AerospaceNU/karman-pcb/Karman Eagle/Karman Projects/Dev Board/Current/Rev 1/Pictures/IMG_20190504_142327.jpg

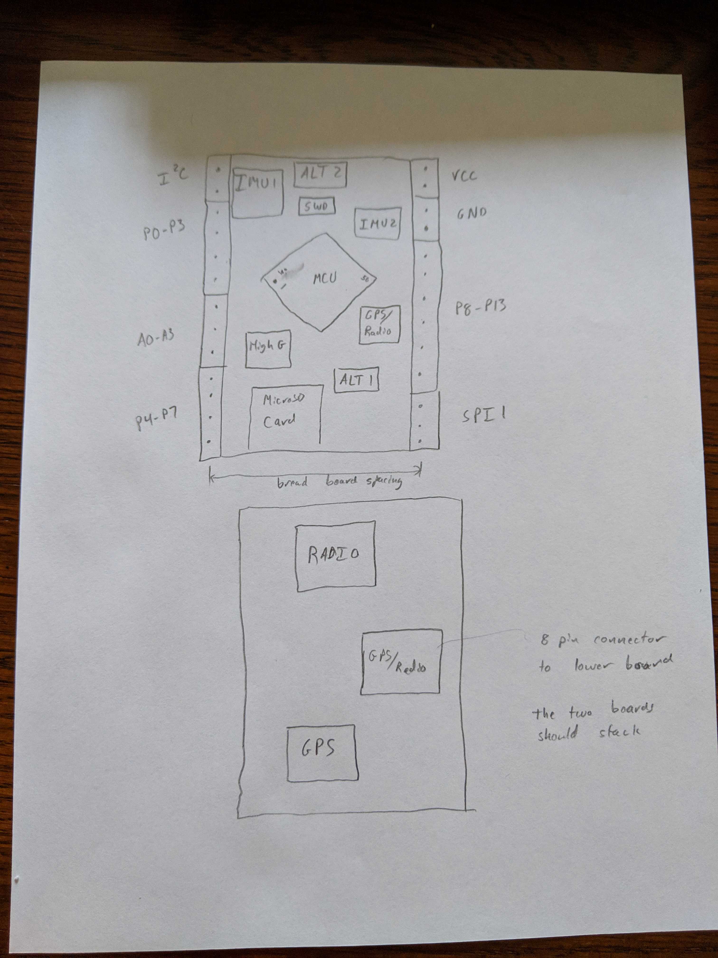
Karman Eagle/Karman Projects/Dev Board/Current/Rev 1/Pictures/IMG_20190504_142327.jpg
