AerospaceNU/karman-pcb/Karman Eagle/Karman Projects/Dev Board/Current/Rev 1/Pictures/20190513_203405.jpg

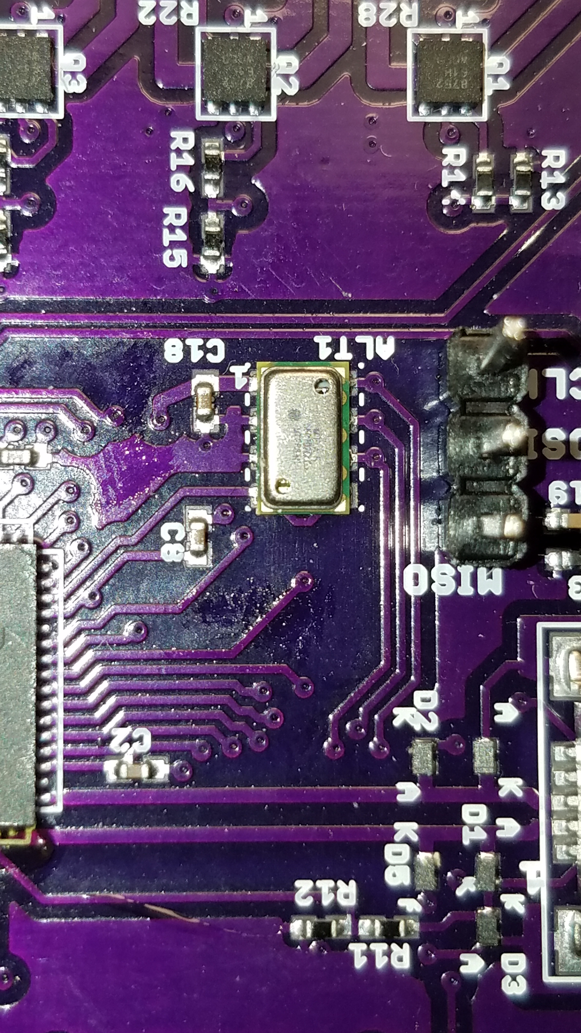
Karman Eagle/Karman Projects/Dev Board/Current/Rev 1/Pictures/20190513_203405.jpg
