AerospaceNU/karman-pcb/README.md

# karman-pcb
F.R.I.D.A.Y Board Pin Assignments:
https://docs.google.com/spreadsheets/d/11na9Qc9M955UdeKwvUbW7dzbBuk4ku73/edit#gid=1635462536
