AerospaceNU/karman-pcb/Karman Eagle/File Structure Explanation.docx

Karman Eagle File Structure

The file structure is based off this guy:

http://www.kieranoleary.com/eagle-pcb-project-directory-structure/

I did this to try and keep all our Eagle files as organized as possible since it’s difficult to move and change files around later.

Structure Tree:

Karman Eagle

Karman Libraries

Component Datasheets

<Library for each component>

Karman Projects

Dev Board

Archive

Current

Rev 1

Bill of Materials

Calculations

PDF

Pictures

Reviews

<Dev Board.sch>

<Dev Board.brd>

<eagle.epf>

GPS-Radio Module

Archive

Current

Rev 1

Bill of Materials

Calculations

PDF

Pictures

Reviews

<Dev Board.sch>

<Dev Board.brd>

<eagle.epf>
