AerospaceNU/karman-pcb/Karman Eagle/Karman Projects/Dev Board/Current/Rev 1/Calculations/Crystal Oscillator Capacitor Calculation.pdf

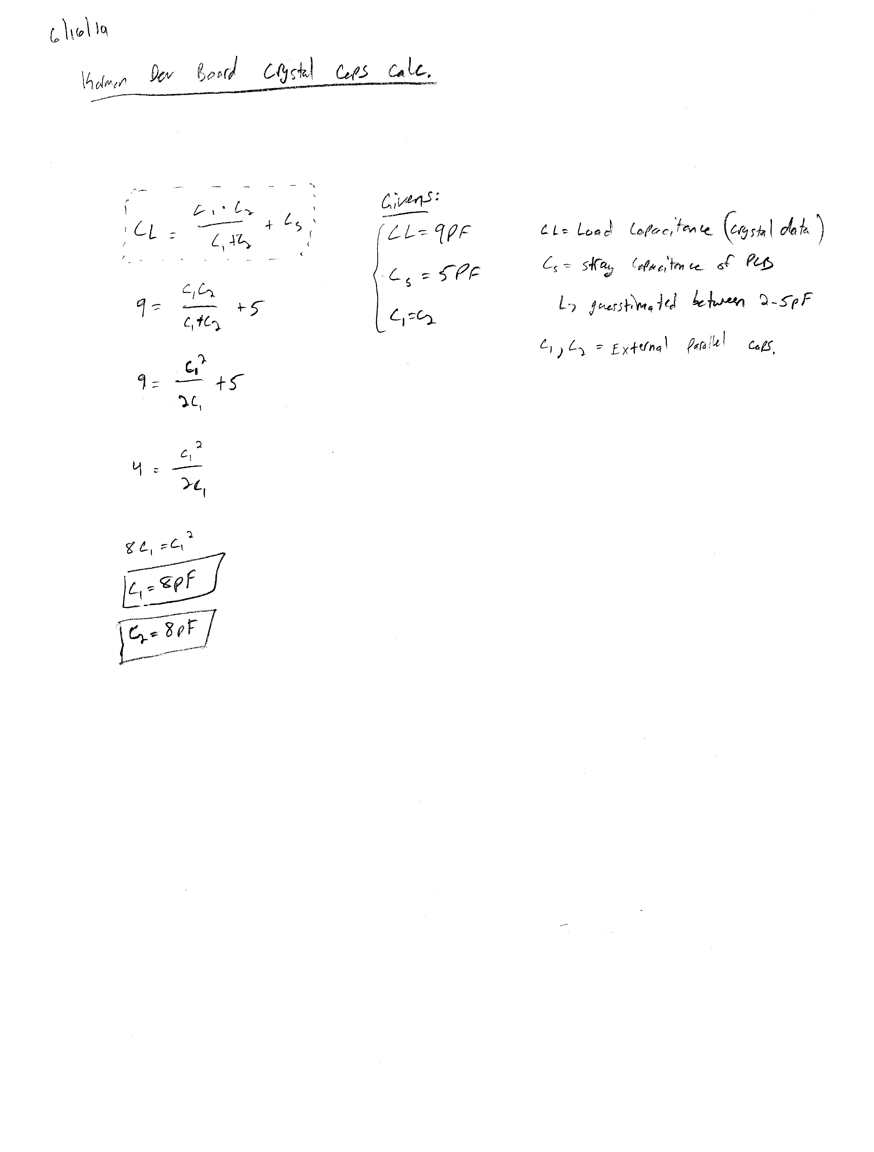
[picture p3: page 1]
