AerospaceNU/karman-pcb/Karman Eagle/Karman Projects/Dev Board/Current/Rev 1/Board Exports/190801-Dev Board Rev 1 Layout.png

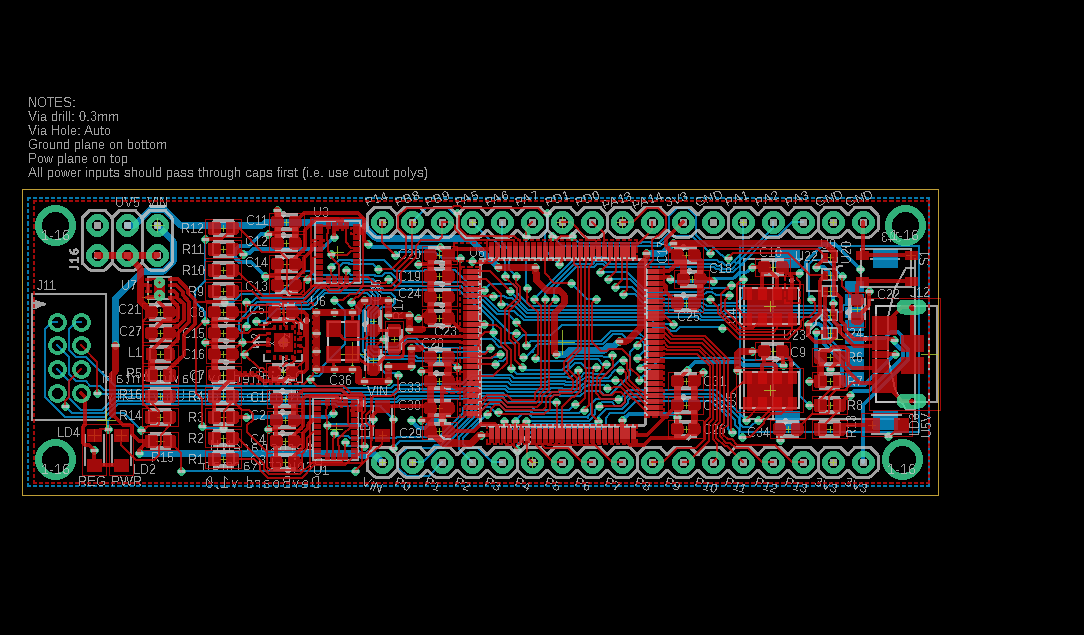
Karman Eagle/Karman Projects/Dev Board/Current/Rev 1/Board Exports/190801-Dev Board Rev 1 Layout.png
