AerospaceNU/karman-pcb/Karman Eagle/Karman Projects/Dev Board/Current/Rev 1/Board Exports/1906262044-Dev Board.png

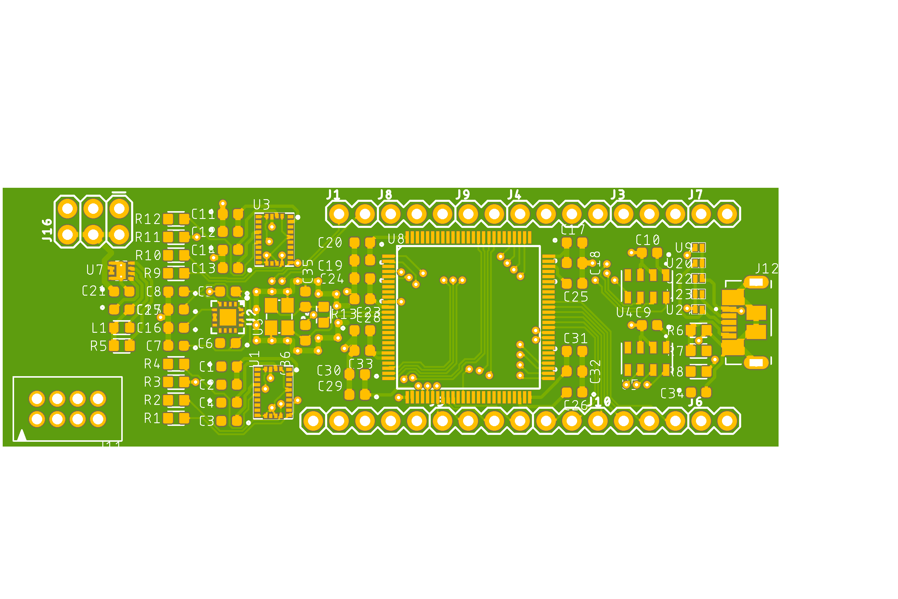
Karman Eagle/Karman Projects/Dev Board/Current/Rev 1/Board Exports/1906262044-Dev Board.png
