AerospaceNU/karman-pcb/Karman Eagle/Karman Projects/Dev Board/Current/Rev 1/Bill of Materials/1906152158-Dev Board BOM.xlsx

Column1 | Column2 | Column3 | Column4 | Column5 | Column8 | Column10 | Column11
Part | Value | Device | Package | Description | DESCRIPTION | MP | PACKAGE
C1 | 120nF | CGA3E2X7R1H104K080AD | CAPC1608X95N | CGA Series 0603 0.1 uF 50 V Â±10% X7R SMT Multilayer Ceramic Capacitor | CGA Series 0603 0.1 uF 50 V Â±10% X7R SMT Multilayer Ceramic Capacitor | CGA3E2X7R1H104K080AD | 0603 TDK
C2 | 6.8nF | CGA3E2X7R1H104K080AD | CAPC1608X95N | CGA Series 0603 0.1 uF 50 V Â±10% X7R SMT Multilayer Ceramic Capacitor | CGA Series 0603 0.1 uF 50 V Â±10% X7R SMT Multilayer Ceramic Capacitor | CGA3E2X7R1H104K080AD | 0603 TDK
C3 | 100nF | CGA3E2X7R1H104K080AD | CAPC1608X95N | CGA Series 0603 0.1 uF 50 V Â±10% X7R SMT Multilayer Ceramic Capacitor | CGA Series 0603 0.1 uF 50 V Â±10% X7R SMT Multilayer Ceramic Capacitor | CGA3E2X7R1H104K080AD | 0603 TDK
C4 | 100nF | CGA3E2X7R1H104K080AD | CAPC1608X95N | CGA Series 0603 0.1 uF 50 V Â±10% X7R SMT Multilayer Ceramic Capacitor | CGA Series 0603 0.1 uF 50 V Â±10% X7R SMT Multilayer Ceramic Capacitor | CGA3E2X7R1H104K080AD | 0603 TDK
C5 | 100nF | CGA3E2X7R1H104K080AD | CAPC1608X95N | CGA Series 0603 0.1 uF 50 V Â±10% X7R SMT Multilayer Ceramic Capacitor | CGA Series 0603 0.1 uF 50 V Â±10% X7R SMT Multilayer Ceramic Capacitor | CGA3E2X7R1H104K080AD | 0603 TDK
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
C25 | 2.2uF | CGA3E2X7R1H104K080AD | CAPC1608X95N | CGA Series 0603 0.1 uF 50 V Â±10% X7R SMT Multilayer Ceramic Capacitor | CGA Series 0603 0.1 uF 50 V Â±10% X7R SMT Multilayer Ceramic Capacitor | CGA3E2X7R1H104K080AD | 0603 TDK
C26 | 2.2uF | CGA3E2X7R1H104K080AD | CAPC1608X95N | CGA Series 0603 0.1 uF 50 V Â±10% X7R SMT Multilayer Ceramic Capacitor | CGA Series 0603 0.1 uF 50 V Â±10% X7R SMT Multilayer Ceramic Capacitor | CGA3E2X7R1H104K080AD | 0603 TDK
C27 | 22uF | CGA3E2X7R1H104K080AD | CAPC1608X95N | CGA Series 0603 0.1 uF 50 V Â±10% X7R SMT Multilayer Ceramic Capacitor | CGA Series 0603 0.1 uF 50 V Â±10% X7R SMT Multilayer Ceramic Capacitor | CGA3E2X7R1H104K080AD | 0603 TDK
C28 | 1uF | CGA3E2X7R1H104K080AD | CAPC1608X95N | CGA Series 0603 0.1 uF 50 V Â±10% X7R SMT Multilayer Ceramic Capacitor | CGA Series 0603 0.1 uF 50 V Â±10% X7R SMT Multilayer Ceramic Capacitor | CGA3E2X7R1H104K080AD | 0603 TDK
C29 | 100nF | CGA3E2X7R1H104K080AD | CAPC1608X95N | CGA Series 0603 0.1 uF 50 V Â±10% X7R SMT Multilayer Ceramic Capacitor | CGA Series 0603 0.1 uF 50 V Â±10% X7R SMT Multilayer Ceramic Capacitor | CGA3E2X7R1H104K080AD | 0603 TDK
C30 | 4.7uF | CGA3E2X7R1H104K080AD | CAPC1608X95N | CGA Series 0603 0.1 uF 50 V Â±10% X7R SMT Multilayer Ceramic Capacitor | CGA Series 0603 0.1 uF 50 V Â±10% X7R SMT Multilayer Ceramic Capacitor | CGA3E2X7R1H104K080AD | 0603 TDK
C31 | 100nF | CGA3E2X7R1H104K080AD | CAPC1608X95N | CGA Series 0603 0.1 uF 50 V Â±10% X7R SMT Multilayer Ceramic Capacitor | CGA Series 0603 0.1 uF 50 V Â±10% X7R SMT Multilayer Ceramic Capacitor | CGA3E2X7R1H104K080AD | 0603 TDK
C32 | 4.7uF | CGA3E2X7R1H104K080AD | CAPC1608X95N | CGA Series 0603 0.1 uF 50 V Â±10% X7R SMT Multilayer Ceramic Capacitor | CGA Series 0603 0.1 uF 50 V Â±10% X7R SMT Multilayer Ceramic Capacitor | CGA3E2X7R1H104K080AD | 0603 TDK
C33 | 10nF | CGA3E2X7R1H104K080AD | CAPC1608X95N | CGA Series 0603 0.1 uF 50 V Â±10% X7R SMT Multilayer Ceramic Capacitor | CGA Series 0603 0.1 uF 50 V Â±10% X7R SMT Multilayer Ceramic Capacitor | CGA3E2X7R1H104K080AD | 0603 TDK
C34 | 4.7nF | CGA3E2X7R1H104K080AD | CAPC1608X95N | CGA Series 0603 0.1 uF 50 V Â±10% X7R SMT Multilayer Ceramic Capacitor | CGA Series 0603 0.1 uF 50 V Â±10% X7R SMT Multilayer Ceramic Capacitor | CGA3E2X7R1H104K080AD | 0603 TDK
J1 | I2C1 | CONN_02 | 1X02 | Multi connection point. Often used as Generic Header-pin footprint for 0.1 inch spaced/style header connections
J2 | P0-P3 | CONN_04 | 1X04 | Multi connection point. Often used as Generic Header-pin footprint for 0.1 inch spaced/style header connections
J3 | A0-A3 | CONN_03 | 1X03 | Multi connection point. Often used as Generic Header-pin footprint for 0.1 inch spaced/style header connections
J4 | Debug | CONN_04 | 1X04 | Multi connection point. Often used as Generic Header-pin footprint for 0.1 inch spaced/style header connections
J5 | P4-P7 | CONN_04 | 1X04 | Multi connection point. Often used as Generic Header-pin footprint for 0.1 inch spaced/style header connections
J6 | VCC | CONN_02 | 1X02 | Multi connection point. Often used as Generic Header-pin footprint for 0.1 inch spaced/style header connections
J7 | GND | CONN_02 | 1X02 | Multi connection point. Often used as Generic Header-pin footprint for 0.1 inch spaced/style header connections
J8 | SPI1 | CONN_03 | 1X03 | Multi connection point. Often used as Generic Header-pin footprint for 0.1 inch spaced/style header connections
J9 | UART5 | CONN_02 | 1X02 | Multi connection point. Often used as Generic Header-pin footprint for 0.1 inch spaced/style header connections
J10 | P8-P13 | CONN_06LOCK | 1X06_LOCK | Multi connection point. Often used as Generic Header-pin footprint for 0.1 inch spaced/style header connections
J11 |  | 087831-0819 | 87831-0819
J12 | 105164-0001 | 105164-0001 | MOLEX_105164-0001 | Micro-USB B Receptacle without Flange, Top Mount, Surface Mount, Lead-Free | Micro-USB B Receptacle without Flange, Top Mount, Surface Mount, Lead-Free | 105164-0001 | None
J43 | 47219-2001 | 47219-2001 | MOLEX_47219-2001 | 1.10mm Pitch microSD Card Connector, Hinge Type, Lead-Freehttp://www.snapeda.com/parts/47219-2001/Molex%20/%20Waldom/view-part/# | Conn Micro SD Card SKT 8 POS 1.1mm Solder RA SMD 0.5A/Contact Embossed T/R | 47219-2001 | None
L1 | 2.2uH | MLF1608E100J | INDC1608X95N | Ind Shielded Multi-Layer 10uH 5% 2MHz 30Q-Factor Ferrite 10mA 0603 | Inductor RF Chip Shielded Multi-Layer 10uH 5% 2MHz 30Q-Factor Ferrite 10mA 1.7Ohm DCR 0603 T/R | MLF1608E100J | 0603 TDK
R1 | 40k | CRGH0603F221K | RESC1608X50N | Res Thick Film 0603 221K Ohm 1% 1/5W Â±100ppm/Â°C Molded SMD SMD T/R | Res Thick Film 0603 221K Ohm 1% 1/5W Â±100ppm/Â°C Molded SMD SMD T/R | CRGH0603F221K | 0603 TE Connectivity
R2 | 40k | CRGH0603F221K | RESC1608X50N | Res Thick Film 0603 221K Ohm 1% 1/5W Â±100ppm/Â°C Molded SMD SMD T/R | Res Thick Film 0603 221K Ohm 1% 1/5W Â±100ppm/Â°C Molded SMD SMD T/R | CRGH0603F221K | 0603 TE Connectivity
R3 | 10k | CRGH0603F221K | RESC1608X50N | Res Thick Film 0603 221K Ohm 1% 1/5W Â±100ppm/Â°C Molded SMD SMD T/R | Res Thick Film 0603 221K Ohm 1% 1/5W Â±100ppm/Â°C Molded SMD SMD T/R | CRGH0603F221K | 0603 TE Connectivity
R4 | 10k | CRGH0603F221K | RESC1608X50N | Res Thick Film 0603 221K Ohm 1% 1/5W Â±100ppm/Â°C Molded SMD SMD T/R | Res Thick Film 0603 221K Ohm 1% 1/5W Â±100ppm/Â°C Molded SMD SMD T/R | CRGH0603F221K | 0603 TE Connectivity
R5 | 100k | CRGH0603F221K | RESC1608X50N | Res Thick Film 0603 221K Ohm 1% 1/5W Â±100ppm/Â°C Molded SMD SMD T/R | Res Thick Film 0603 221K Ohm 1% 1/5W Â±100ppm/Â°C Molded SMD SMD T/R | CRGH0603F221K | 0603 TE Connectivity
R6 | 1M | CRGH0603F221K | RESC1608X50N | Res Thick Film 0603 221K Ohm 1% 1/5W Â±100ppm/Â°C Molded SMD SMD T/R | Res Thick Film 0603 221K Ohm 1% 1/5W Â±100ppm/Â°C Molded SMD SMD T/R | CRGH0603F221K | 0603 TE Connectivity
R7 | 59k | CRGH0603F221K | RESC1608X50N | Res Thick Film 0603 221K Ohm 1% 1/5W Â±100ppm/Â°C Molded SMD SMD T/R | Res Thick Film 0603 221K Ohm 1% 1/5W Â±100ppm/Â°C Molded SMD SMD T/R | CRGH0603F221K | 0603 TE Connectivity
R8 | 42.2k | CRGH0603F221K | RESC1608X50N | Res Thick Film 0603 221K Ohm 1% 1/5W Â±100ppm/Â°C Molded SMD SMD T/R | Res Thick Film 0603 221K Ohm 1% 1/5W Â±100ppm/Â°C Molded SMD SMD T/R | CRGH0603F221K | 0603 TE Connectivity
R9 | 40k | CRGH0603F221K | RESC1608X50N | Res Thick Film 0603 221K Ohm 1% 1/5W Â±100ppm/Â°C Molded SMD SMD T/R | Res Thick Film 0603 221K Ohm 1% 1/5W Â±100ppm/Â°C Molded SMD SMD T/R | CRGH0603F221K | 0603 TE Connectivity
R10 | 40k | CRGH0603F221K | RESC1608X50N | Res Thick Film 0603 221K Ohm 1% 1/5W Â±100ppm/Â°C Molded SMD SMD T/R | Res Thick Film 0603 221K Ohm 1% 1/5W Â±100ppm/Â°C Molded SMD SMD T/R | CRGH0603F221K | 0603 TE Connectivity
R11 | 10k | CRGH0603F221K | RESC1608X50N | Res Thick Film 0603 221K Ohm 1% 1/5W Â±100ppm/Â°C Molded SMD SMD T/R | Res Thick Film 0603 221K Ohm 1% 1/5W Â±100ppm/Â°C Molded SMD SMD T/R | CRGH0603F221K | 0603 TE Connectivity
R12 | 10k | CRGH0603F221K | RESC1608X50N | Res Thick Film 0603 221K Ohm 1% 1/5W Â±100ppm/Â°C Molded SMD SMD T/R | Res Thick Film 0603 221K Ohm 1% 1/5W Â±100ppm/Â°C Molded SMD SMD T/R | CRGH0603F221K | 0603 TE Connectivity
U1 | BNO055 | BNO055 | LGA28R50P4X10_380X520X100 | BNO055 9-axis Absolute Orientation Sensor ( SiP ) w/Sensors and Sensor Fusion | BNO055 9-axis Absolute Orientation Sensor _ SiP _ w/Sensors and Sensor Fusion | BNO055 | LGA-28 Bosch
U2 | ADXL377 | ADXL377 | LFCSP-16-3X3 | Analog Devices ADXL377 Low Power 3-Axis Â±200 g Accelerometer with Analog Output | ADI Small, Low Power, 3-Axis +/-3g3x3x1.45mm | ADXL377 | None
U3 | BNO055 | BNO055 | LGA28R50P4X10_380X520X100 | BNO055 9-axis Absolute Orientation Sensor ( SiP ) w/Sensors and Sensor Fusion | BNO055 9-axis Absolute Orientation Sensor _ SiP _ w/Sensors and Sensor Fusion | BNO055 | LGA-28 Bosch
U4 | MS5607-02BA03 | MS5607-02BA03 | TE_MS860702BA01-50
U5 | MS5607-02BA03 | MS5607-02BA03 | TE_MS860702BA01-50
U6 | TSX-3225 | TSX-3225 | TSX-3225
U7 | TPS62172 | TPS62172 | TPS62172
U8 | STM32F767VIT6 | STM32F767VIT6 | LQFP100_14X14
U20 | PESD3V3S1UL | PESD3V3S1UL | SOD882 | PESD3V3S1UL Zener Diode
U22 | PESD3V3S1UL | PESD3V3S1UL | SOD882 | PESD3V3S1UL Zener Diode
U23 | PESD3V3S1UL | PESD3V3S1UL | SOD882 | PESD3V3S1UL Zener Diode
U24 | PESD3V3S1UL | PESD3V3S1UL | SOD882 | PESD3V3S1UL Zener Diode
