AerospaceNU/karman-pcb/Karman Eagle/Karman Projects/Dev Board/Current/Rev 1/Board Exports/1906262044-Dev Board (Actual Size).pdf

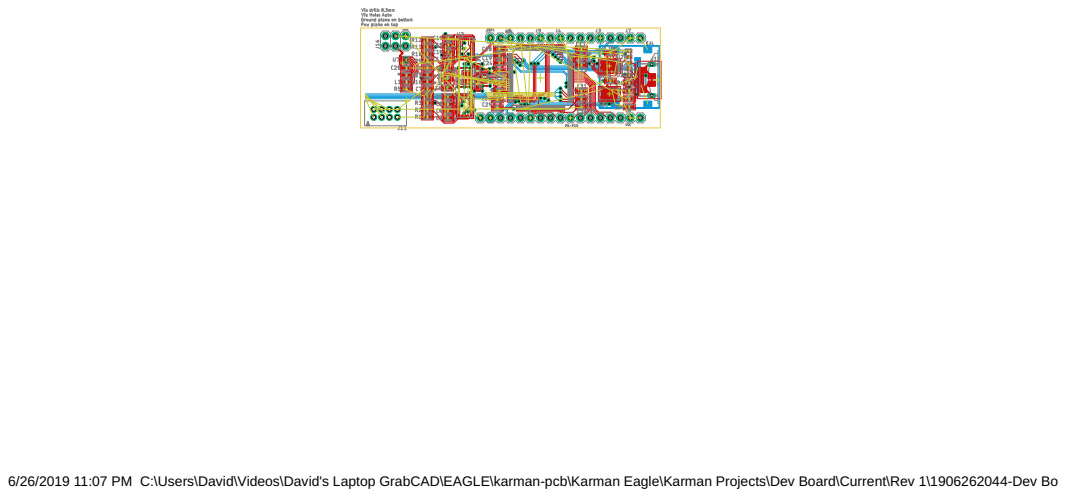
[picture p6: page 1]

6/26/2019 11:07 PM C:\Users\David\Videos\David's Laptop GrabCAD\EAGLE\karman-pcb\Karman Eagle\Karman Projects\Dev Board\Current\Rev 1\1906262044-Dev Board.brd
