AerospaceNU/karman-pcb/Karman Eagle/Karman Projects/Dev Board/Current/Rev 1/Board Exports/1906262044-Dev Board.pdf

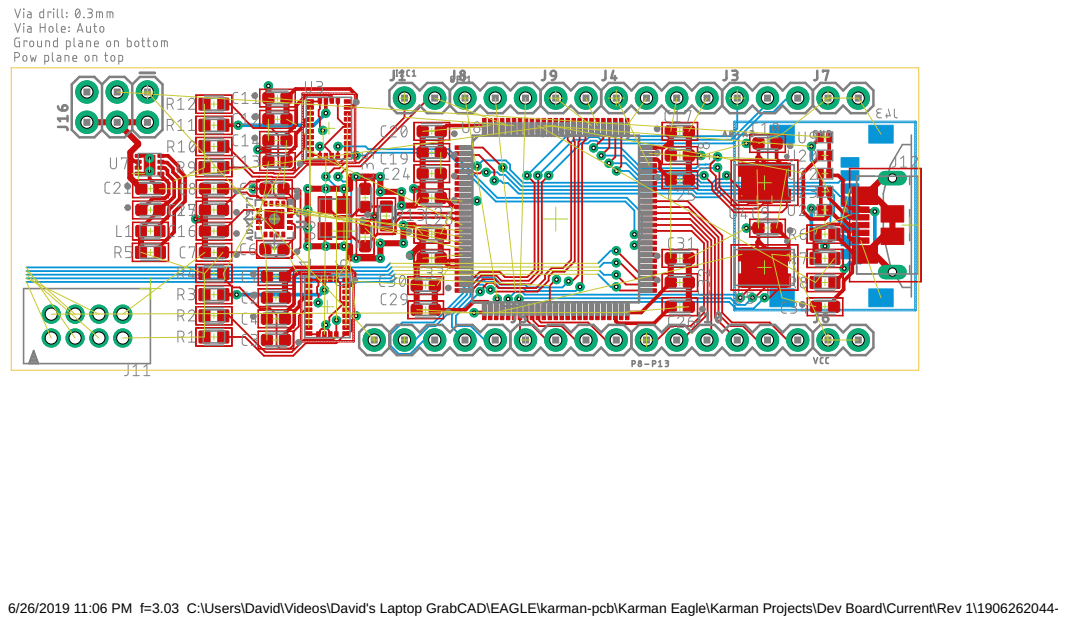
[picture p7: page 1]

6/26/2019 11:06 PM f=3.03 C:\Users\David\Videos\David's Laptop GrabCAD\EAGLE\karman-pcb\Karman Eagle\Karman Projects\Dev Board\Current\Rev 1\1906262044-Dev Board.brd
