AerospaceNU/karman-pcb/Karman Eagle/Karman Projects/Dev Board/Current/Rev 1/Reviews/1905251245-Dev Board [ISSUED FOR REVIEW].pdf

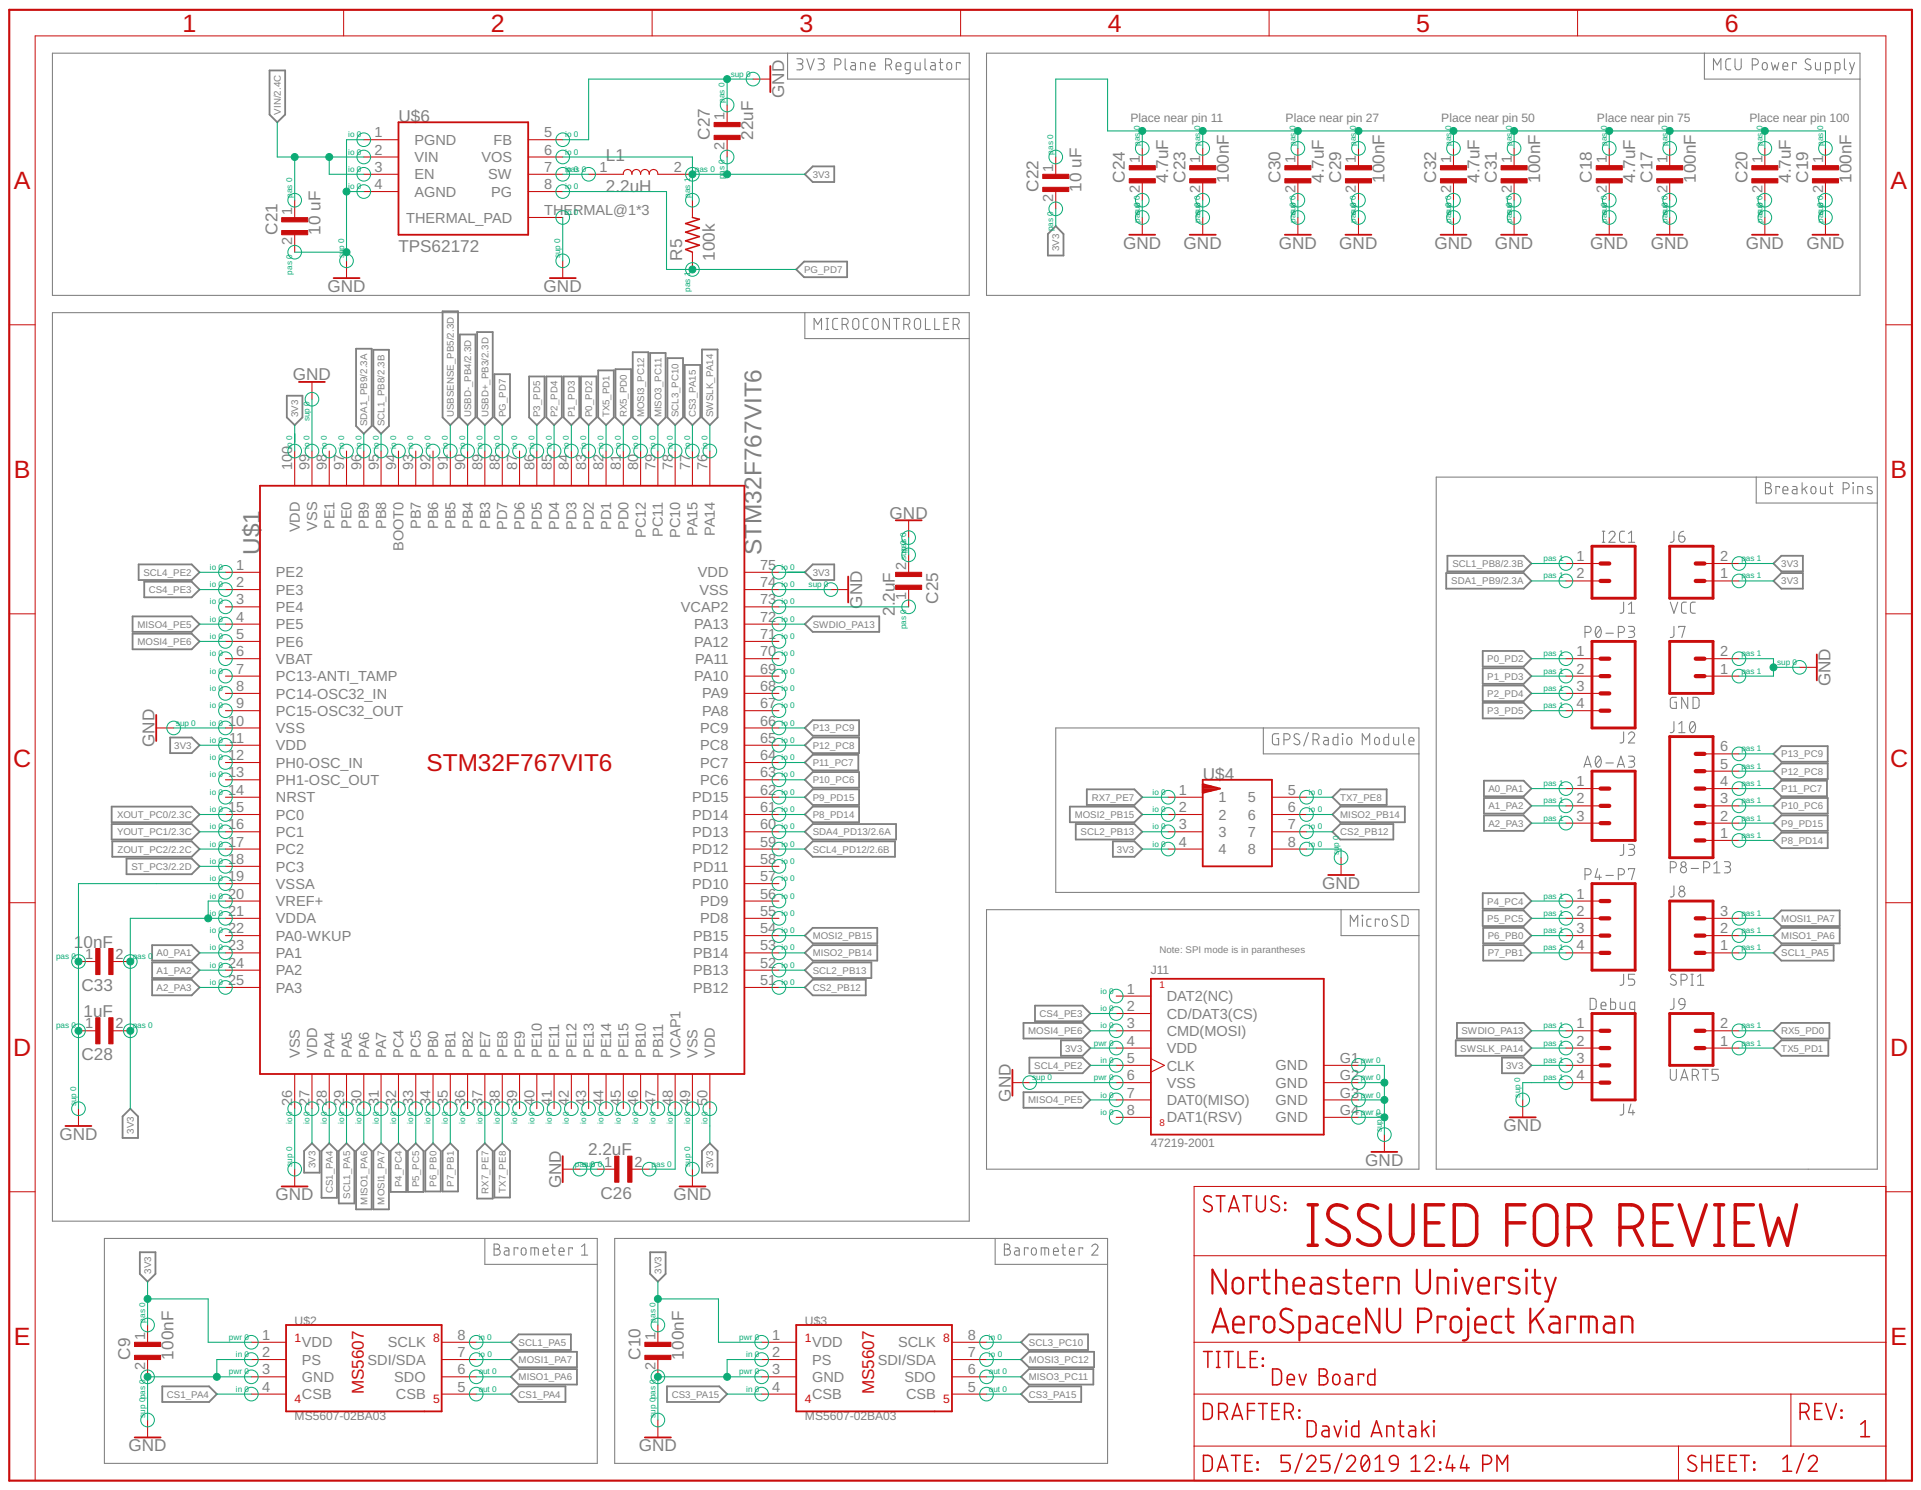
[picture p8: page 1]

Note: SPI mode is in parantheses

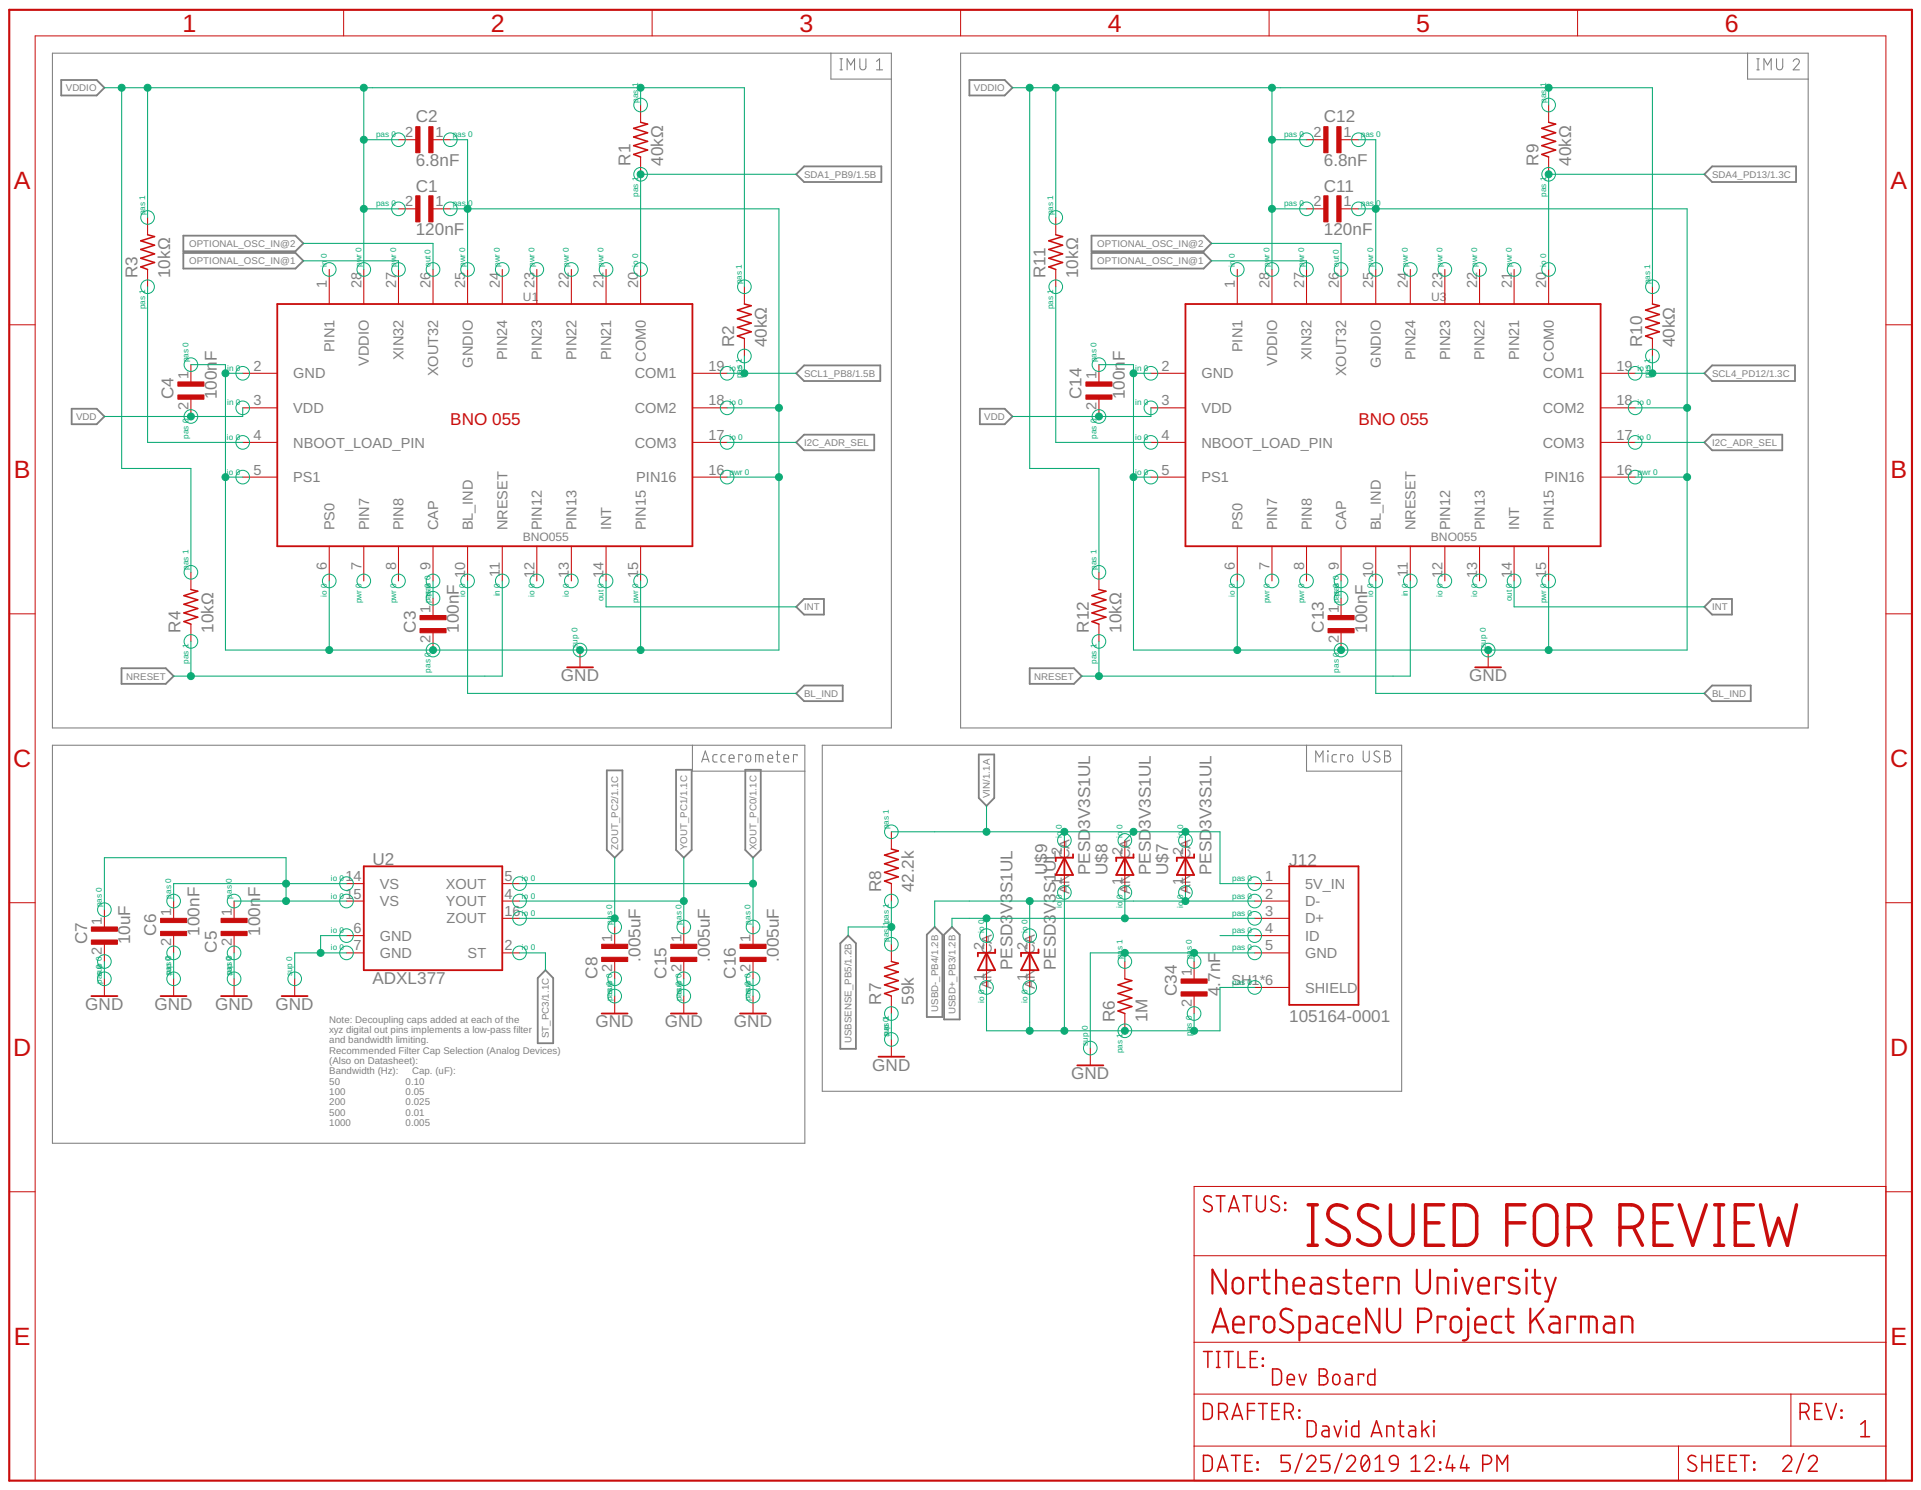
[picture p9: page 2]

pas 1 pas 1 pas 1 pas 1 sup 0

Note: Decoupling caps added at each of the
xyz digital out pins implements a low-pass filter and bandwidth limiting. Recommended Filter Cap Selection (Analog Devices)
