AerospaceNU/karman-pcb/Karman Eagle/Karman Projects/Dev Board/Current/Rev 1/1908011900-Dev Board.brd

## EAGLE design Karman Eagle/Karman Projects/Dev Board/Current/Rev 1/1908011900-Dev Board.brd (2020-05-07)

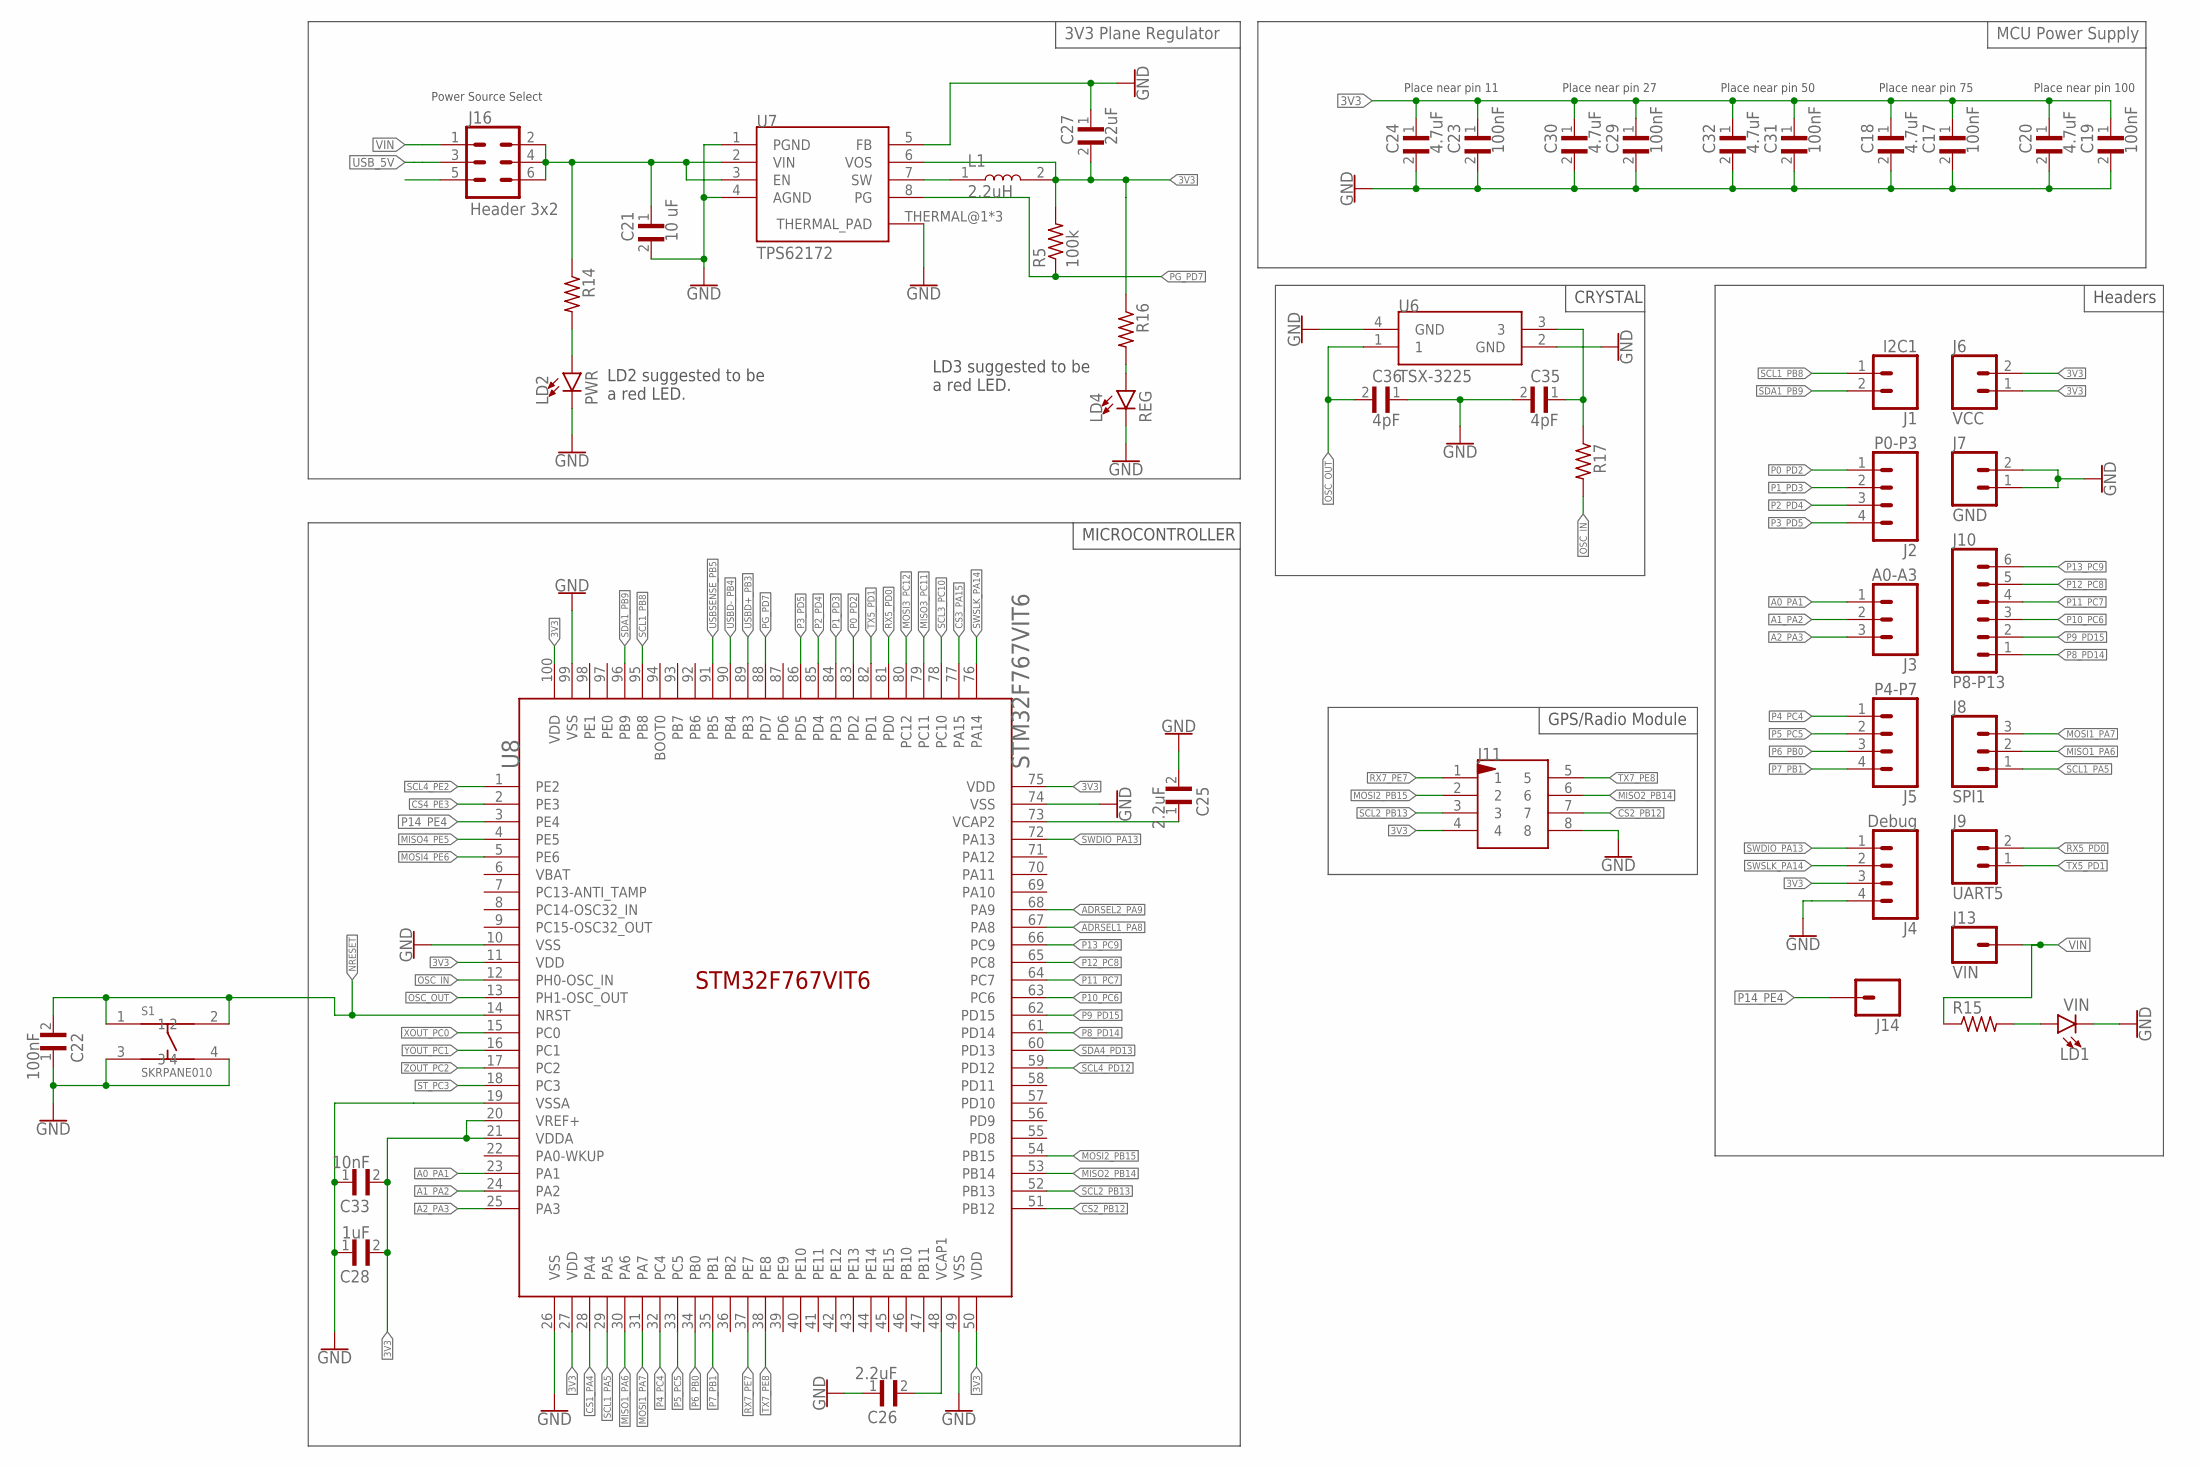
[picture p10: schematic 1908011900-Dev Board.sch, sheet 1]

Parts:
C17, C19, C22, C23, C29, C31: 100nF; CAPC1608X95N
C18, C20, C24, C30, C32: 4.7uF; CAPC1608X95N
C21: 10 uF; CAPC1608X95N
C25, C26: 2.2uF; CAPC1608X95N
C27: 22uF; CAPC1608X95N
C28: 1uF; CAPC1608X95N
C33: 10nF; CAPC1608X95N
C35, C36: 4pF; CAPC1608X95N
J1: I2C1; 1X02
J2: P0-P3; 1X04
J3: A0-A3; 1X03
J4: Debug; 1X04
J5: P4-P7; 1X04
J6: VCC; 1X02
J7: GND; 1X02
J8: SPI1; 1X03
J9: UART5; 1X02
J10: P8-P13; 1X06
J11: 087831-0819; 87831-0819
J13: VIN; 1X01
J14: CONN_01; 1X01
J16: Header 3x2; 2X3
L1: 2.2uH; INDC1608X95N
LD1: VIN; 0805_LED
LD2: PWR; 0805_LED
LD4: REG; 0805_LED
R5: 100k; RESC1608X50N
R14, R15, R16, R17: CRGH0603F221K; RESC1608X50N
S1: SKRPANE010
U6: TSX-3225
U7: TPS62172
U8: STM32F767VIT6; LQFP100_14X14

Connections:
3V3: C17.1, C18.1, C19.1, C20.1, C23.1, C24.1, C27.2, C28.2, C29.1, C30.1, C31.1, C32.1, C33.2, J4.3, J6.1, J6.2, J11.4, L1.2, R5.2, R16.1, U7.6 (VOS), U8.11 (VDD), U8.20 (VREF+), U8.21 (VDDA), U8.27 (VDD), U8.50 (VDD), U8.75 (VDD), U8.100 (VDD); also elsewhere on the board
A0_PA1: J3.1, U8.23 (PA1)
A1_PA2: J3.2, U8.24 (PA2)
A2_PA3: J3.3, U8.25 (PA3)
ADRSEL1_PA8: U8.67 (PA8); also elsewhere on the board
ADRSEL2_PA9: U8.68 (PA9); also elsewhere on the board
CS1_PA4: U8.28 (PA4); also elsewhere on the board
CS2_PB12: J11.7, U8.51 (PB12)
CS3_PA15: U8.77 (PA15); also elsewhere on the board
CS4_PE3: U8.2 (PE3); also elsewhere on the board
GND: C17.2, C18.2, C19.2, C20.2, C21.2, C22.1, C23.2, C24.2, C25.2, C26.1, C28.1, C29.2, C30.2, C31.2, C32.2, C33.1, C35.2, C36.1, J4.4, J7.1, J7.2, J11.8, LD1.C, LD2.C, LD4.C, S1.3, S1.4, U6.2 (GND), U6.4 (GND), U7.1 (PGND), U7.4 (AGND), U7.THERMAL@1 (THERMAL_PAD), U7.THERMAL@2 (THERMAL_PAD), U7.THERMAL@3 (THERMAL_PAD), U8.10 (VSS), U8.19 (VSSA), U8.26 (VSS), U8.49 (VSS), U8.74 (VSS), U8.99 (VSS); also elsewhere on the board
MISO1_PA6: J8.2, U8.30 (PA6); also elsewhere on the board
MISO2_PB14: J11.6, U8.53 (PB14)
MISO3_PC11: U8.79 (PC11); also elsewhere on the board
MISO4_PE5: U8.4 (PE5); also elsewhere on the board
MOSI1_PA7: J8.3, U8.31 (PA7); also elsewhere on the board
MOSI2_PB15: J11.2, U8.54 (PB15)
MOSI3_PC12: U8.80 (PC12); also elsewhere on the board
MOSI4_PE6: U8.5 (PE6); also elsewhere on the board
unnamed: C25.1, U8.73 (VCAP2)
unnamed: C26.2, U8.48 (VCAP1)
unnamed: L1.1, U7.7 (SW)
unnamed: LD1.A, R15.2
unnamed: LD2.A, R14.2
unnamed: C27.1, U7.5 (FB)
unnamed: C35.1, R17.1, U6.3
unnamed: C21.1, J16.2, J16.4, J16.6, R14.1, U7.2 (VIN), U7.3 (EN)
unnamed: LD4.A, R16.2
NRESET: C22.2, S1.1, S1.2, U8.14 (NRST); also elsewhere on the board
OSC_IN: R17.2, U8.12 (PH0-OSC_IN)
OSC_OUT: C36.2, U6.1, U8.13 (PH1-OSC_OUT)
P0_PD2: J2.1, U8.83 (PD2)
P1_PD3: J2.2, U8.84 (PD3)
P2_PD4: J2.3, U8.85 (PD4)
P3_PD5: J2.4, U8.86 (PD5)
P4_PC4: J5.1, U8.32 (PC4)
P5_PC5: J5.2, U8.33 (PC5)
P6_PB0: J5.3, U8.34 (PB0)
P7_PB1: J5.4, U8.35 (PB1)
P8_PD14: J10.1, U8.61 (PD14)
P9_PD15: J10.2, U8.62 (PD15)
P10_PC6: J10.3, U8.63 (PC6)
P11_PC7: J10.4, U8.64 (PC7)
P12_PC8: J10.5, U8.65 (PC8)
P13_PC9: J10.6, U8.66 (PC9)
P14_PE4: J14.1, U8.3 (PE4)
PG_PD7: R5.1, U7.8 (PG), U8.88 (PD7)
RX5_PD0: J9.2, U8.81 (PD0)
RX7_PE7: J11.1, U8.37 (PE7)
SCL1_PA5: J8.1, U8.29 (PA5); also elsewhere on the board
SCL1_PB8: J1.1, U8.95 (PB8); also elsewhere on the board
SCL2_PB13: J11.3, U8.52 (PB13)
SCL3_PC10: U8.78 (PC10); also elsewhere on the board
SCL4_PD12: U8.59 (PD12); also elsewhere on the board
SCL4_PE2: U8.1 (PE2); also elsewhere on the board
SDA1_PB9: J1.2, U8.96 (PB9); also elsewhere on the board
SDA4_PD13: U8.60 (PD13); also elsewhere on the board
ST_PC3: U8.18 (PC3); also elsewhere on the board
SWDIO_PA13: J4.1, U8.72 (PA13)
SWSLK_PA14: J4.2, U8.76 (PA14)
TX5_PD1: J9.1, U8.82 (PD1)
TX7_PE8: J11.5, U8.38 (PE8)
USBD+_PB3: U8.89 (PB3); also elsewhere on the board
USBD-_PB4: U8.90 (PB4); also elsewhere on the board
USBSENSE_PB5: U8.91 (PB5); also elsewhere on the board
USB_5V: J16.3; also elsewhere on the board
VIN: J13.1, J16.1, R15.1
XOUT_PC0: U8.15 (PC0); also elsewhere on the board
YOUT_PC1: U8.16 (PC1); also elsewhere on the board
ZOUT_PC2: U8.17 (PC2); also elsewhere on the board

Notes on the sheet:
MICROCONTROLLER
Headers
Place near pin 11
Place near pin 27
Place near pin 50
Place near pin 75
Place near pin 100
GPS/Radio Module
MCU Power Supply
3V3 Plane Regulator
CRYSTAL
Power Source Select
LD2 suggested to be a red LED.
LD3 suggested to be a red LED.

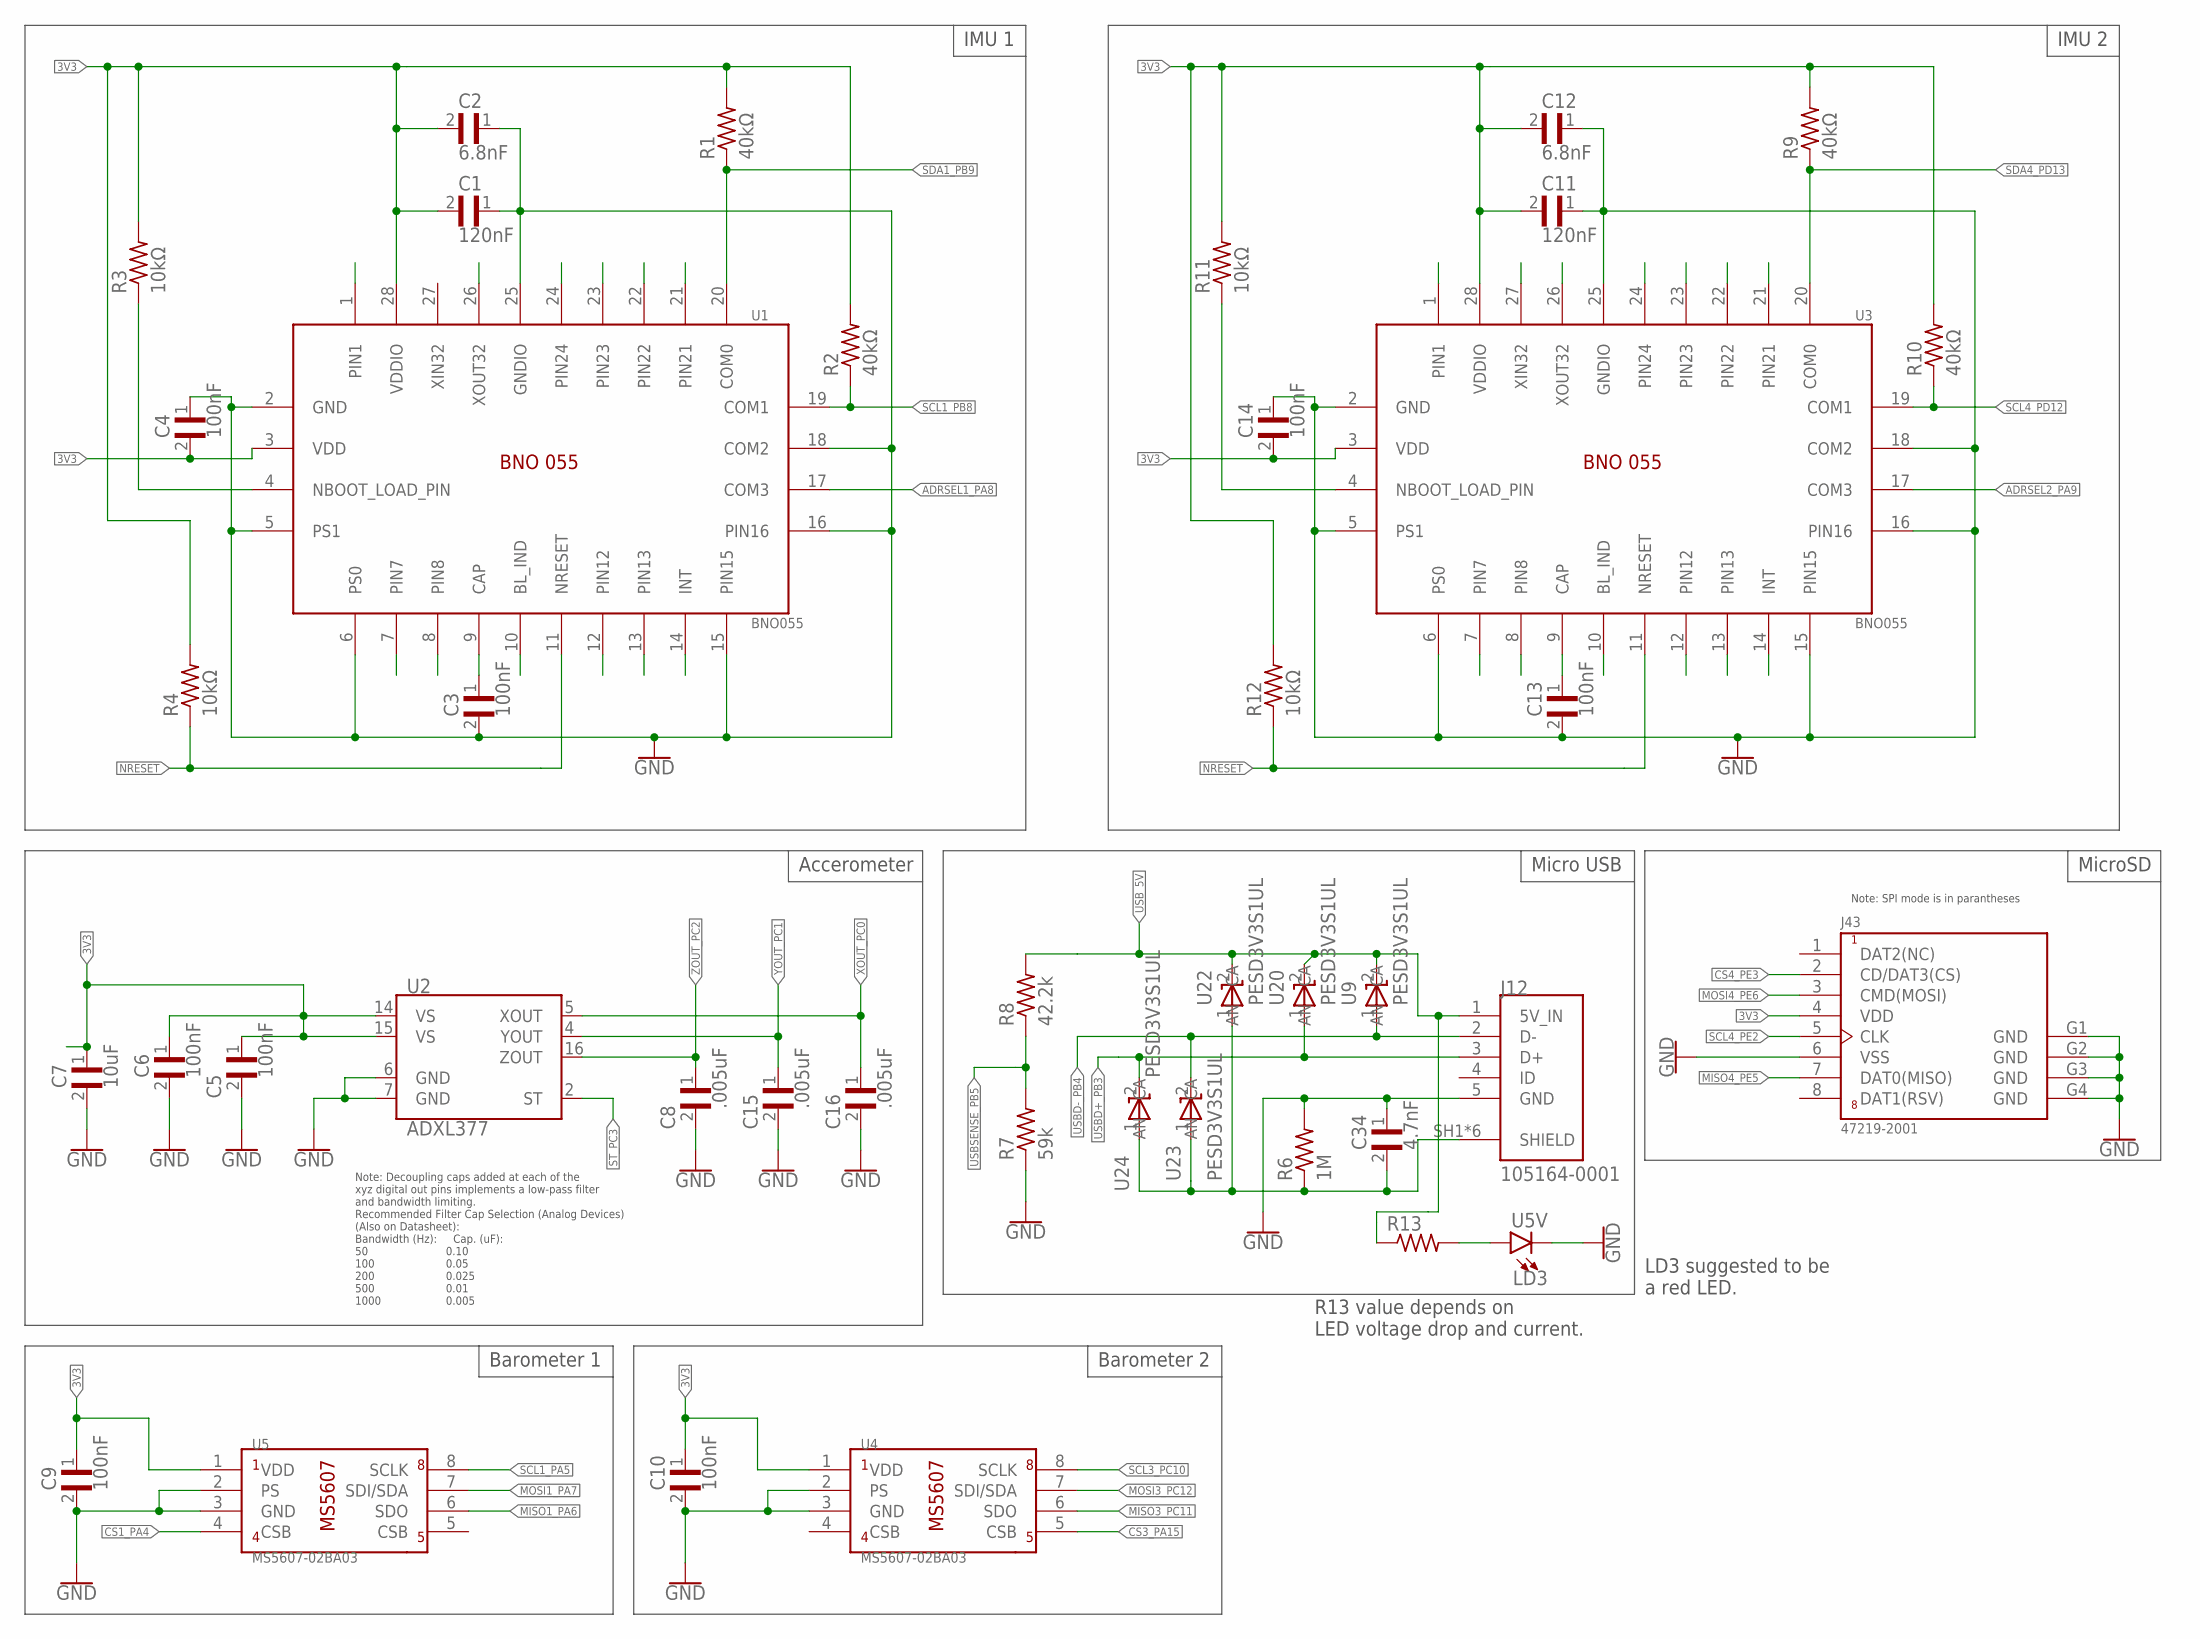
[picture p11: schematic 1908011900-Dev Board.sch, sheet 2]

Parts:
C1, C11: 120nF; CAPC1608X95N
C2, C12: 6.8nF; CAPC1608X95N
C3, C4, C5, C6, C9, C10, C13, C14: 100nF; CAPC1608X95N
C7: 10uF; CAPC1608X95N
C8, C15, C16: .005uF; CAPC1608X95N
C34: 4.7nF; CAPC1608X95N
J12: 105164-0001; MOLEX_105164-0001
J43: 47219-2001; MOLEX_47219-2001
LD3: U5V; 0805_LED
R1, R2, R9, R10: 40kΩ; RESC1608X50N
R3, R4, R11, R12: 10kΩ; RESC1608X50N
R6: 1M; RESC1608X50N
R7: 59k; RESC1608X50N
R8: 42.2k; RESC1608X50N
R13: CRGH0603F221K; RESC1608X50N
U1, U3: BNO055; LGA28R50P4X10_380X520X100
U2: ADXL377; LFCSP-16-3X3
U4, U5: MS5607-02BA03; TE_MS860702BA01-50
U9, U20, U22, U23, U24: PESD3V3S1UL; SOD882

Connections:
3V3: C1.2, C2.2, C4.2, C5.1, C6.1, C7.1, C9.1, C10.1, C11.2, C12.2, C14.2, J43.4 (VDD), R1.2, R2.2, R3.2, R4.2, R9.2, R10.2, R11.2, R12.2, U1.3 (VDD), U1.28 (VDDIO), U2.14 (VS), U2.15 (VS), U3.3 (VDD), U3.28 (VDDIO), U4.1 (VDD), U5.1 (VDD); also elsewhere on the board
ADRSEL1_PA8: U1.17 (COM3); also elsewhere on the board
ADRSEL2_PA9: U3.17 (COM3); also elsewhere on the board
CS1_PA4: U5.4 (CSB); also elsewhere on the board
CS3_PA15: U4.5 (CSB); also elsewhere on the board
CS4_PE3: J43.2 (CD/DAT3(CS)); also elsewhere on the board
GND: C1.1, C2.1, C3.2, C4.1, C5.2, C6.2, C7.2, C8.2, C9.2, C10.2, C11.1, C12.1, C13.2, C14.1, C15.2, C16.2, C34.1, J12.5 (GND), J43.6 (VSS), J43.G1 (GND), J43.G2 (GND), J43.G3 (GND), J43.G4 (GND), LD3.C, R6.2, R7.1, U1.2 (GND), U1.5 (PS1), U1.6 (PS0), U1.15 (PIN15), U1.16 (PIN16), U1.18 (COM2), U1.25 (GNDIO), U2.6 (GND), U2.7 (GND), U3.2 (GND), U3.5 (PS1), U3.6 (PS0), U3.15 (PIN15), U3.16 (PIN16), U3.18 (COM2), U3.25 (GNDIO), U4.2 (PS), U4.3 (GND), U5.2 (PS), U5.3 (GND); also elsewhere on the board
MISO1_PA6: U5.6 (SDO); also elsewhere on the board
MISO3_PC11: U4.6 (SDO); also elsewhere on the board
MISO4_PE5: J43.7 (DAT0(MISO)); also elsewhere on the board
MOSI1_PA7: U5.7 (SDI/SDA); also elsewhere on the board
MOSI3_PC12: U4.7 (SDI/SDA); also elsewhere on the board
MOSI4_PE6: J43.3 (CMD(MOSI)); also elsewhere on the board
unnamed: C3.1, U1.9 (CAP)
unnamed: R3.1, U1.4 (NBOOT_LOAD_PIN)
unnamed: C13.1, U3.9 (CAP)
unnamed: R11.1, U3.4 (NBOOT_LOAD_PIN)
unnamed: C34.2, J12.SH1 (SHIELD), J12.SH2 (SHIELD), J12.SH3 (SHIELD), J12.SH4 (SHIELD), J12.SH5 (SHIELD), J12.SH6 (SHIELD), R6.1, U22.1 (CA), U23.1 (CA), U24.1 (CA)
unnamed: LD3.A, R13.2
NRESET: R4.1, R12.1, U1.11 (NRESET), U3.11 (NRESET); also elsewhere on the board
SCL1_PA5: U5.8 (SCLK); also elsewhere on the board
SCL1_PB8: R2.1, U1.19 (COM1); also elsewhere on the board
SCL3_PC10: U4.8 (SCLK); also elsewhere on the board
SCL4_PD12: R10.1, U3.19 (COM1); also elsewhere on the board
SCL4_PE2: J43.5 (CLK); also elsewhere on the board
SDA1_PB9: R1.1, U1.20 (COM0); also elsewhere on the board
SDA4_PD13: R9.1, U3.20 (COM0); also elsewhere on the board
ST_PC3: U2.2 (ST); also elsewhere on the board
USBD+_PB3: J12.3 (D+), U20.1 (CA), U24.2 (AN); also elsewhere on the board
USBD-_PB4: J12.2 (D-), U9.1 (CA), U23.2 (AN); also elsewhere on the board
USBSENSE_PB5: R7.2, R8.1; also elsewhere on the board
USB_5V: J12.1 (5V_IN), R8.2, R13.1, U9.2 (AN), U20.2 (AN), U22.2 (AN); also elsewhere on the board
XIN32: U1.27 (XIN32)
XOUT_PC0: C16.1, U2.5 (XOUT); also elsewhere on the board
YOUT_PC1: C15.1, U2.4 (YOUT); also elsewhere on the board
ZOUT_PC2: C8.1, U2.16 (ZOUT); also elsewhere on the board

Notes on the sheet:
IMU 1
IMU 2
Note: Decoupling caps added at each of the xyz digital out pins implements a low-pass filter and bandwidth limiting. Recommended Filter Cap Selection (Analog Devices) (Also on Datasheet): Bandwidth (Hz): Cap. (uF): 50 0.10 100 0.05 200 0.025 500 0.01 1000 0.005
Accerometer
Micro USB
Barometer 1
Barometer 2
MicroSD
R13 value depends on LED voltage drop and current.
LD3 suggested to be a red LED.

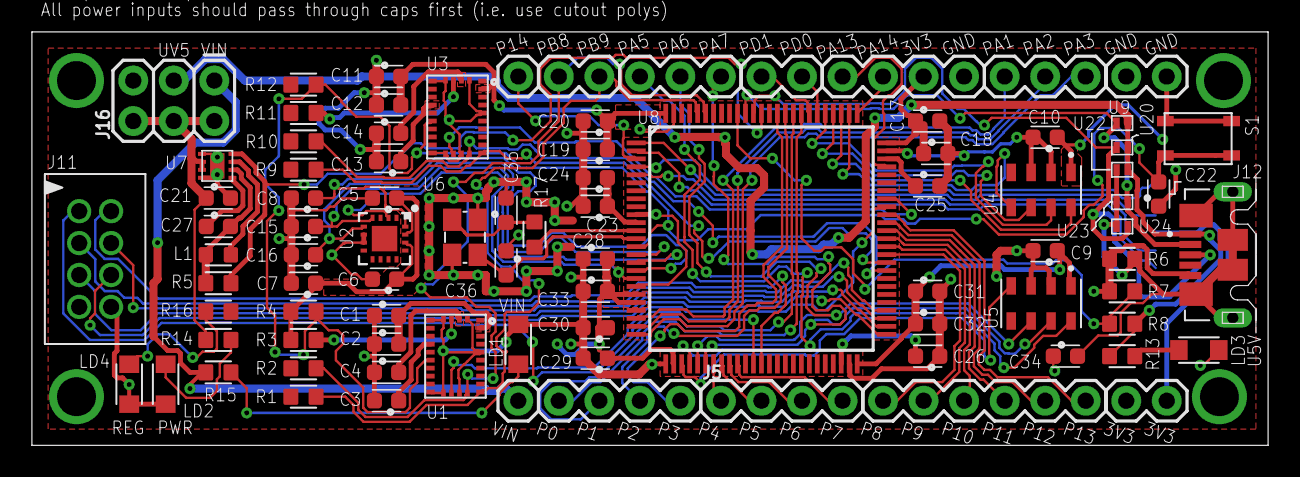
[picture p12: board 1908011900-Dev Board.brd from above]

Board: 2 copper layers, 77.5 x 25.9 mm, 88 parts (1 on the bottom side), 76 nets.
