AerospaceNU/karman-pcb/Karman Eagle/Karman Projects/Dev Board/Current/Rev 1/1906152157-Dev Board.brd

## EAGLE design Karman Eagle/Karman Projects/Dev Board/Current/Rev 1/1906152157-Dev Board.brd (2019-06-16)

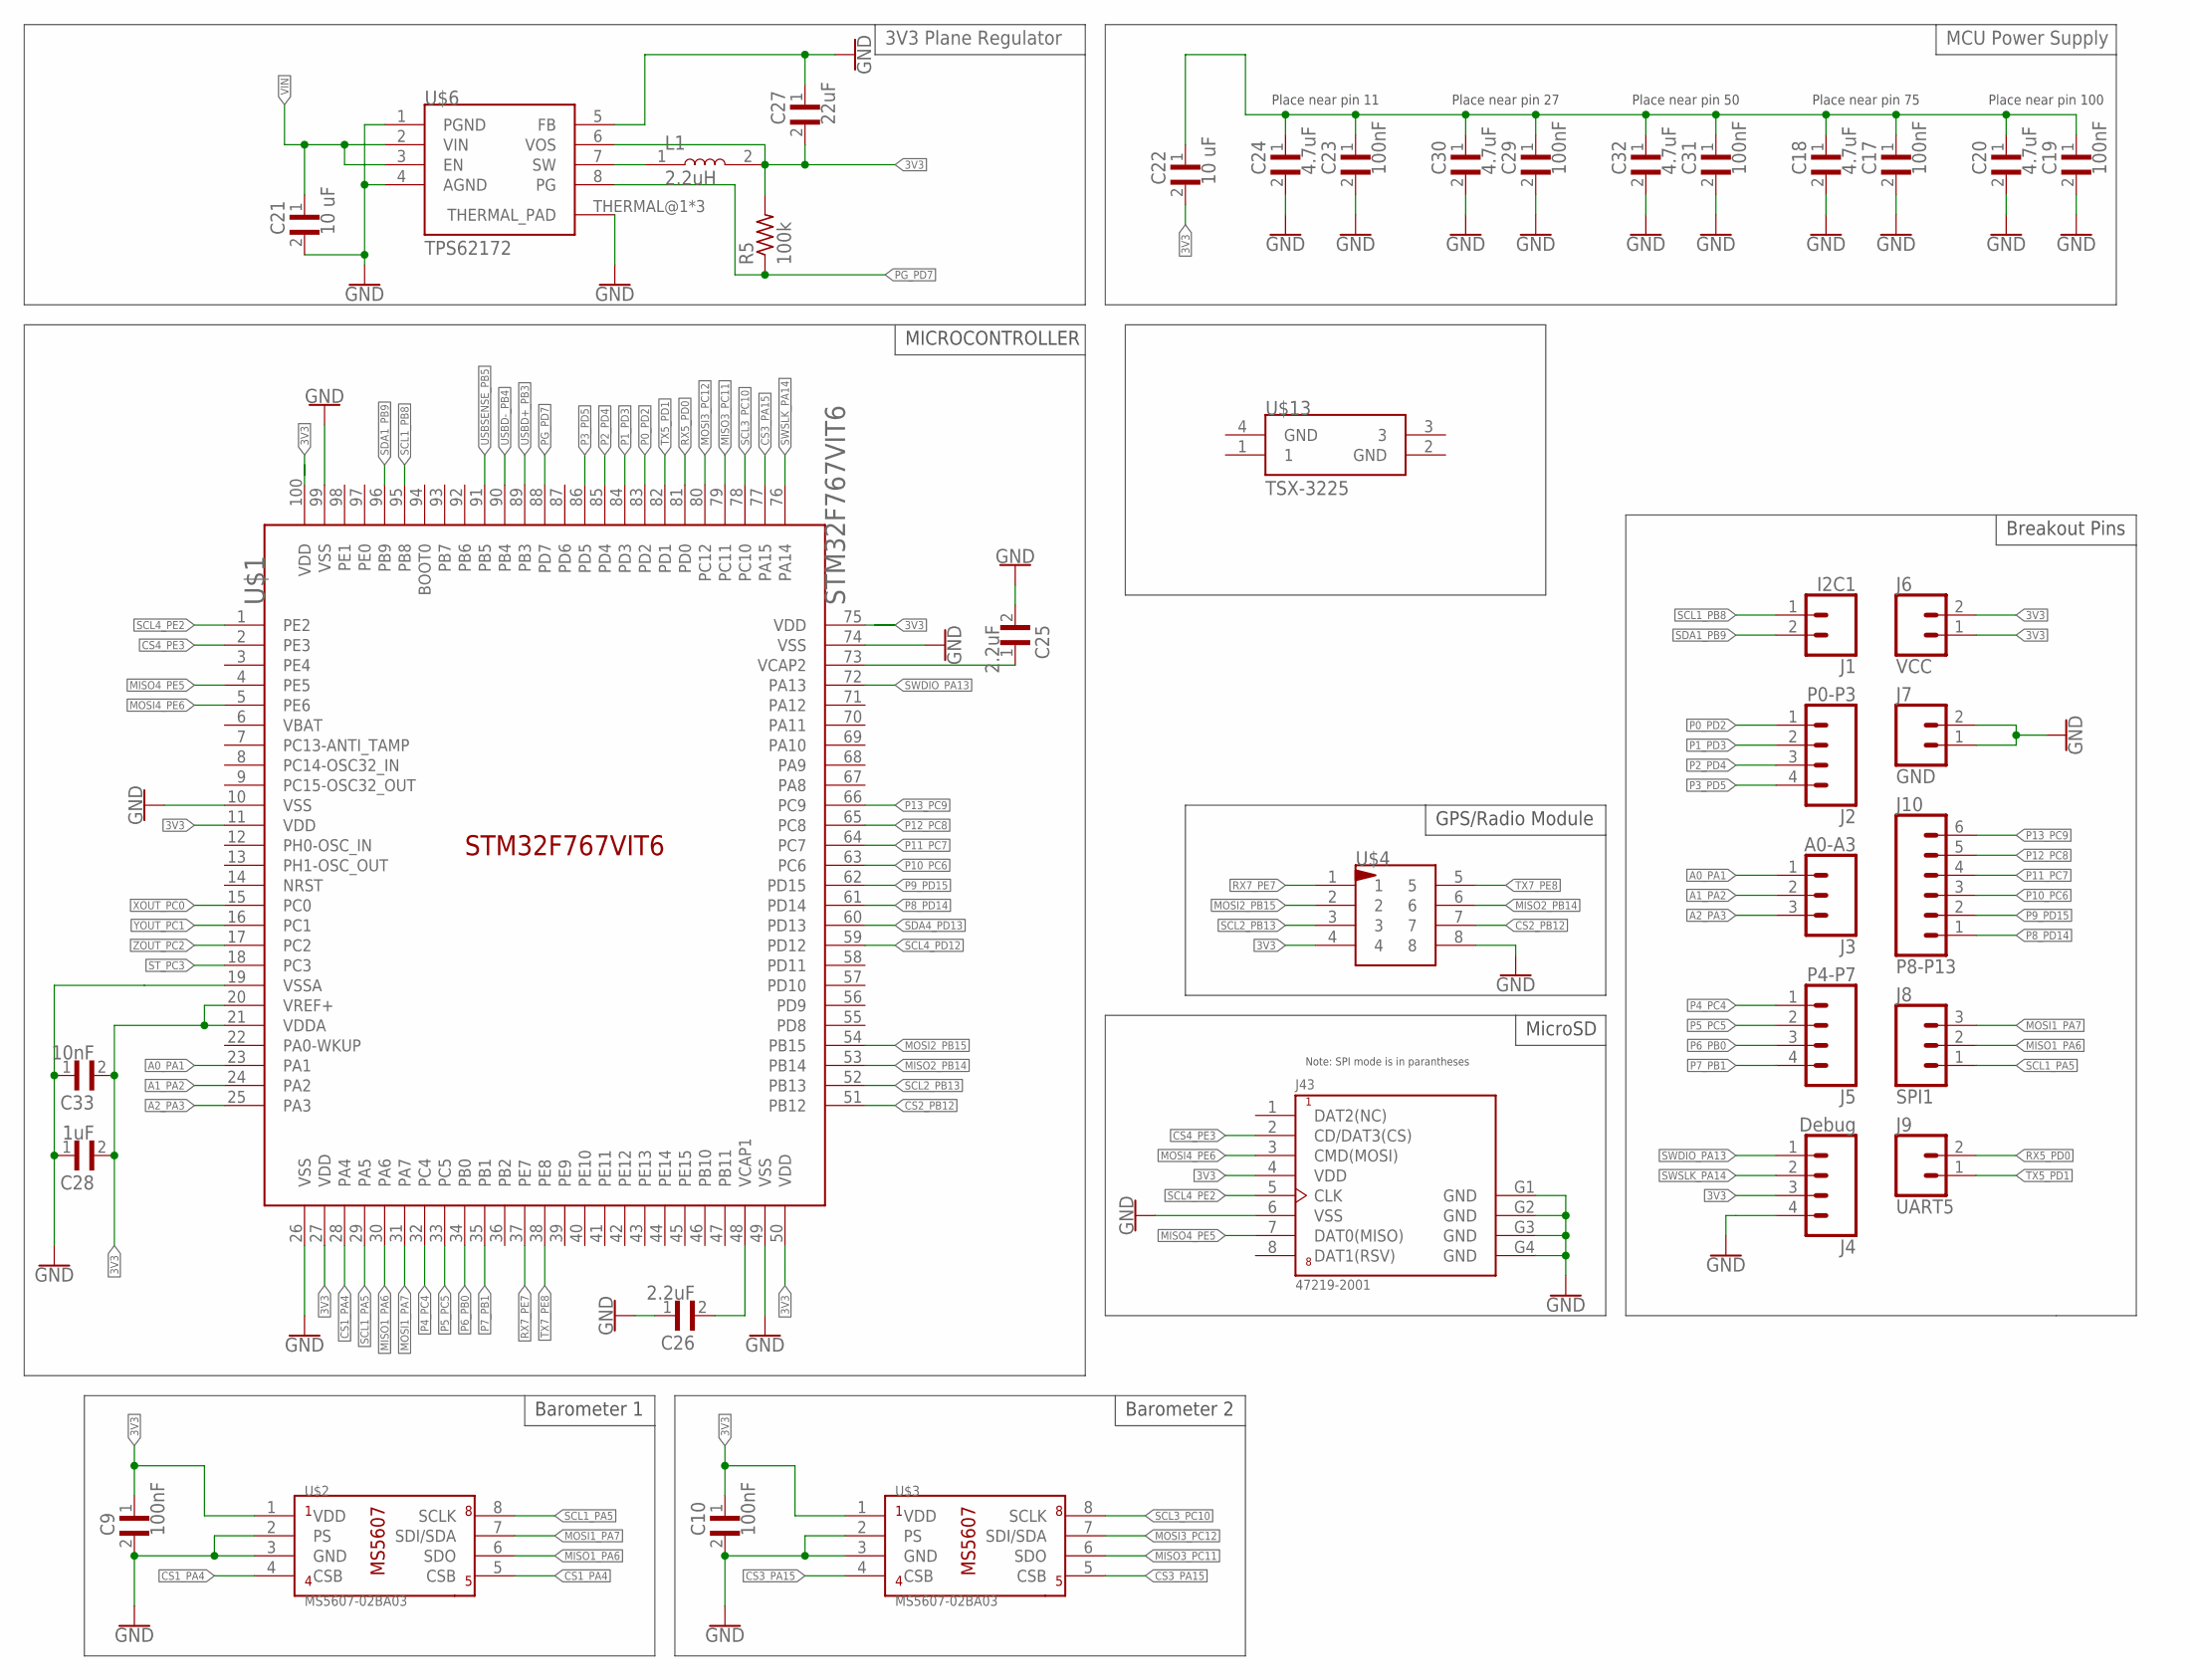
[picture p13: schematic 1906152157-Dev Board.sch, sheet 1]

Parts:
C9, C10, C17, C19, C23, C29, C31: 100nF; CAPC1608X95N
C18, C20, C24, C30, C32: 4.7uF; CAPC1608X95N
C21, C22: 10 uF; CAPC1608X95N
C25, C26: 2.2uF; CAPC1608X95N
C27: 22uF; CAPC1608X95N
C28: 1uF; CAPC1608X95N
C33: 10nF; CAPC1608X95N
J1: I2C1; 1X02
J2: P0-P3; 1X04
J3: A0-A3; 1X03
J4: Debug; 1X04
J5: P4-P7; 1X04
J6: VCC; 1X02
J7: GND; 1X02
J8: SPI1; 1X03
J9: UART5; 1X02
J10: P8-P13; 1X06_LOCK
J43: 47219-2001; MOLEX_47219-2001
L1: 2.2uH; INDC1608X95N
R5: 100k; RESC1608X50N
U$1: STM32F767VIT6; LQFP100_14X14
U$2, U$3: MS5607-02BA03; TE_MS860702BA01-50
U$4: 087831-0819; 87831-0819
U$6: TPS62172
U$13: TSX-3225

Connections:
3V3: C9.1, C10.1, C22.2, C27.2, C28.2, C33.2, J4.3, J6.1, J6.2, J43.4 (VDD), L1.2, R5.2, U$1.11 (VDD), U$1.20 (VREF+), U$1.21 (VDDA), U$1.27 (VDD), U$1.50 (VDD), U$1.75 (VDD), U$1.100 (VDD), U$2.1 (VDD), U$3.1 (VDD), U$4.4, U$6.6 (VOS)
A0_PA1: J3.1, U$1.23 (PA1)
A1_PA2: J3.2, U$1.24 (PA2)
A2_PA3: J3.3, U$1.25 (PA3)
CS1_PA4: U$1.28 (PA4), U$2.4 (CSB), U$2.5 (CSB)
CS2_PB12: U$1.51 (PB12), U$4.7
CS3_PA15: U$1.77 (PA15), U$3.4 (CSB), U$3.5 (CSB)
CS4_PE3: J43.2 (CD/DAT3(CS)), U$1.2 (PE3)
GND: C9.2, C10.2, C17.2, C18.2, C19.2, C20.2, C21.2, C23.2, C24.2, C25.2, C26.1, C27.1, C28.1, C29.2, C30.2, C31.2, C32.2, C33.1, J4.4, J7.1, J7.2, J43.6 (VSS), J43.G1 (GND), J43.G2 (GND), J43.G3 (GND), J43.G4 (GND), U$1.10 (VSS), U$1.19 (VSSA), U$1.26 (VSS), U$1.49 (VSS), U$1.74 (VSS), U$1.99 (VSS), U$2.2 (PS), U$2.3 (GND), U$3.2 (PS), U$3.3 (GND), U$4.8, U$6.1 (PGND), U$6.4 (AGND), U$6.5 (FB), U$6.THERMAL@1 (THERMAL_PAD), U$6.THERMAL@2 (THERMAL_PAD), U$6.THERMAL@3 (THERMAL_PAD); also elsewhere on the board
MISO1_PA6: J8.2, U$1.30 (PA6), U$2.6 (SDO)
MISO2_PB14: U$1.53 (PB14), U$4.6
MISO3_PC11: U$1.79 (PC11), U$3.6 (SDO)
MISO4_PE5: J43.7 (DAT0(MISO)), U$1.4 (PE5)
MOSI1_PA7: J8.3, U$1.31 (PA7), U$2.7 (SDI/SDA)
MOSI2_PB15: U$1.54 (PB15), U$4.2
MOSI3_PC12: U$1.80 (PC12), U$3.7 (SDI/SDA)
MOSI4_PE6: J43.3 (CMD(MOSI)), U$1.5 (PE6)
unnamed: C25.1, U$1.73 (VCAP2)
unnamed: C26.2, U$1.48 (VCAP1)
unnamed: L1.1, U$6.7 (SW)
unnamed: C17.1, C18.1, C19.1, C20.1, C22.1, C23.1, C24.1, C29.1, C30.1, C31.1, C32.1
P0_PD2: J2.1, U$1.83 (PD2)
P1_PD3: J2.2, U$1.84 (PD3)
P2_PD4: J2.3, U$1.85 (PD4)
P3_PD5: J2.4, U$1.86 (PD5)
P4_PC4: J5.1, U$1.32 (PC4)
P5_PC5: J5.2, U$1.33 (PC5)
P6_PB0: J5.3, U$1.34 (PB0)
P7_PB1: J5.4, U$1.35 (PB1)
P8_PD14: J10.1, U$1.61 (PD14)
P9_PD15: J10.2, U$1.62 (PD15)
P10_PC6: J10.3, U$1.63 (PC6)
P11_PC7: J10.4, U$1.64 (PC7)
P12_PC8: J10.5, U$1.65 (PC8)
P13_PC9: J10.6, U$1.66 (PC9)
PG_PD7: R5.1, U$1.88 (PD7), U$6.8 (PG)
RX5_PD0: J9.2, U$1.81 (PD0)
RX7_PE7: U$1.37 (PE7), U$4.1
SCL1_PA5: J8.1, U$1.29 (PA5), U$2.8 (SCLK)
SCL1_PB8: J1.1, U$1.95 (PB8); also elsewhere on the board
SCL2_PB13: U$1.52 (PB13), U$4.3
SCL3_PC10: U$1.78 (PC10), U$3.8 (SCLK)
SCL4_PD12: U$1.59 (PD12); also elsewhere on the board
SCL4_PE2: J43.5 (CLK), U$1.1 (PE2)
SDA1_PB9: J1.2, U$1.96 (PB9); also elsewhere on the board
SDA4_PD13: U$1.60 (PD13); also elsewhere on the board
ST_PC3: U$1.18 (PC3); also elsewhere on the board
SWDIO_PA13: J4.1, U$1.72 (PA13)
SWSLK_PA14: J4.2, U$1.76 (PA14)
TX5_PD1: J9.1, U$1.82 (PD1)
TX7_PE8: U$1.38 (PE8), U$4.5
USBD+_PB3: U$1.89 (PB3); also elsewhere on the board
USBD-_PB4: U$1.90 (PB4); also elsewhere on the board
USBSENSE_PB5: U$1.91 (PB5); also elsewhere on the board
VIN: C21.1, U$6.2 (VIN), U$6.3 (EN); also elsewhere on the board
XOUT_PC0: U$1.15 (PC0); also elsewhere on the board
YOUT_PC1: U$1.16 (PC1); also elsewhere on the board
ZOUT_PC2: U$1.17 (PC2); also elsewhere on the board

Notes on the sheet:
MICROCONTROLLER
Barometer 1
Barometer 2
Breakout Pins
Place near pin 11
Place near pin 27
Place near pin 50
Place near pin 75
Place near pin 100
GPS/Radio Module
MicroSD
MCU Power Supply
3V3 Plane Regulator
