AerospaceNU/karman-pcb/Karman Eagle/Karman Projects/Dev Board/Current/Rev 1/1906152157-Dev Board.brd

## EAGLE design Karman Eagle/Karman Projects/Dev Board/Current/Rev 1/1906152157-Dev Board.brd (continued)

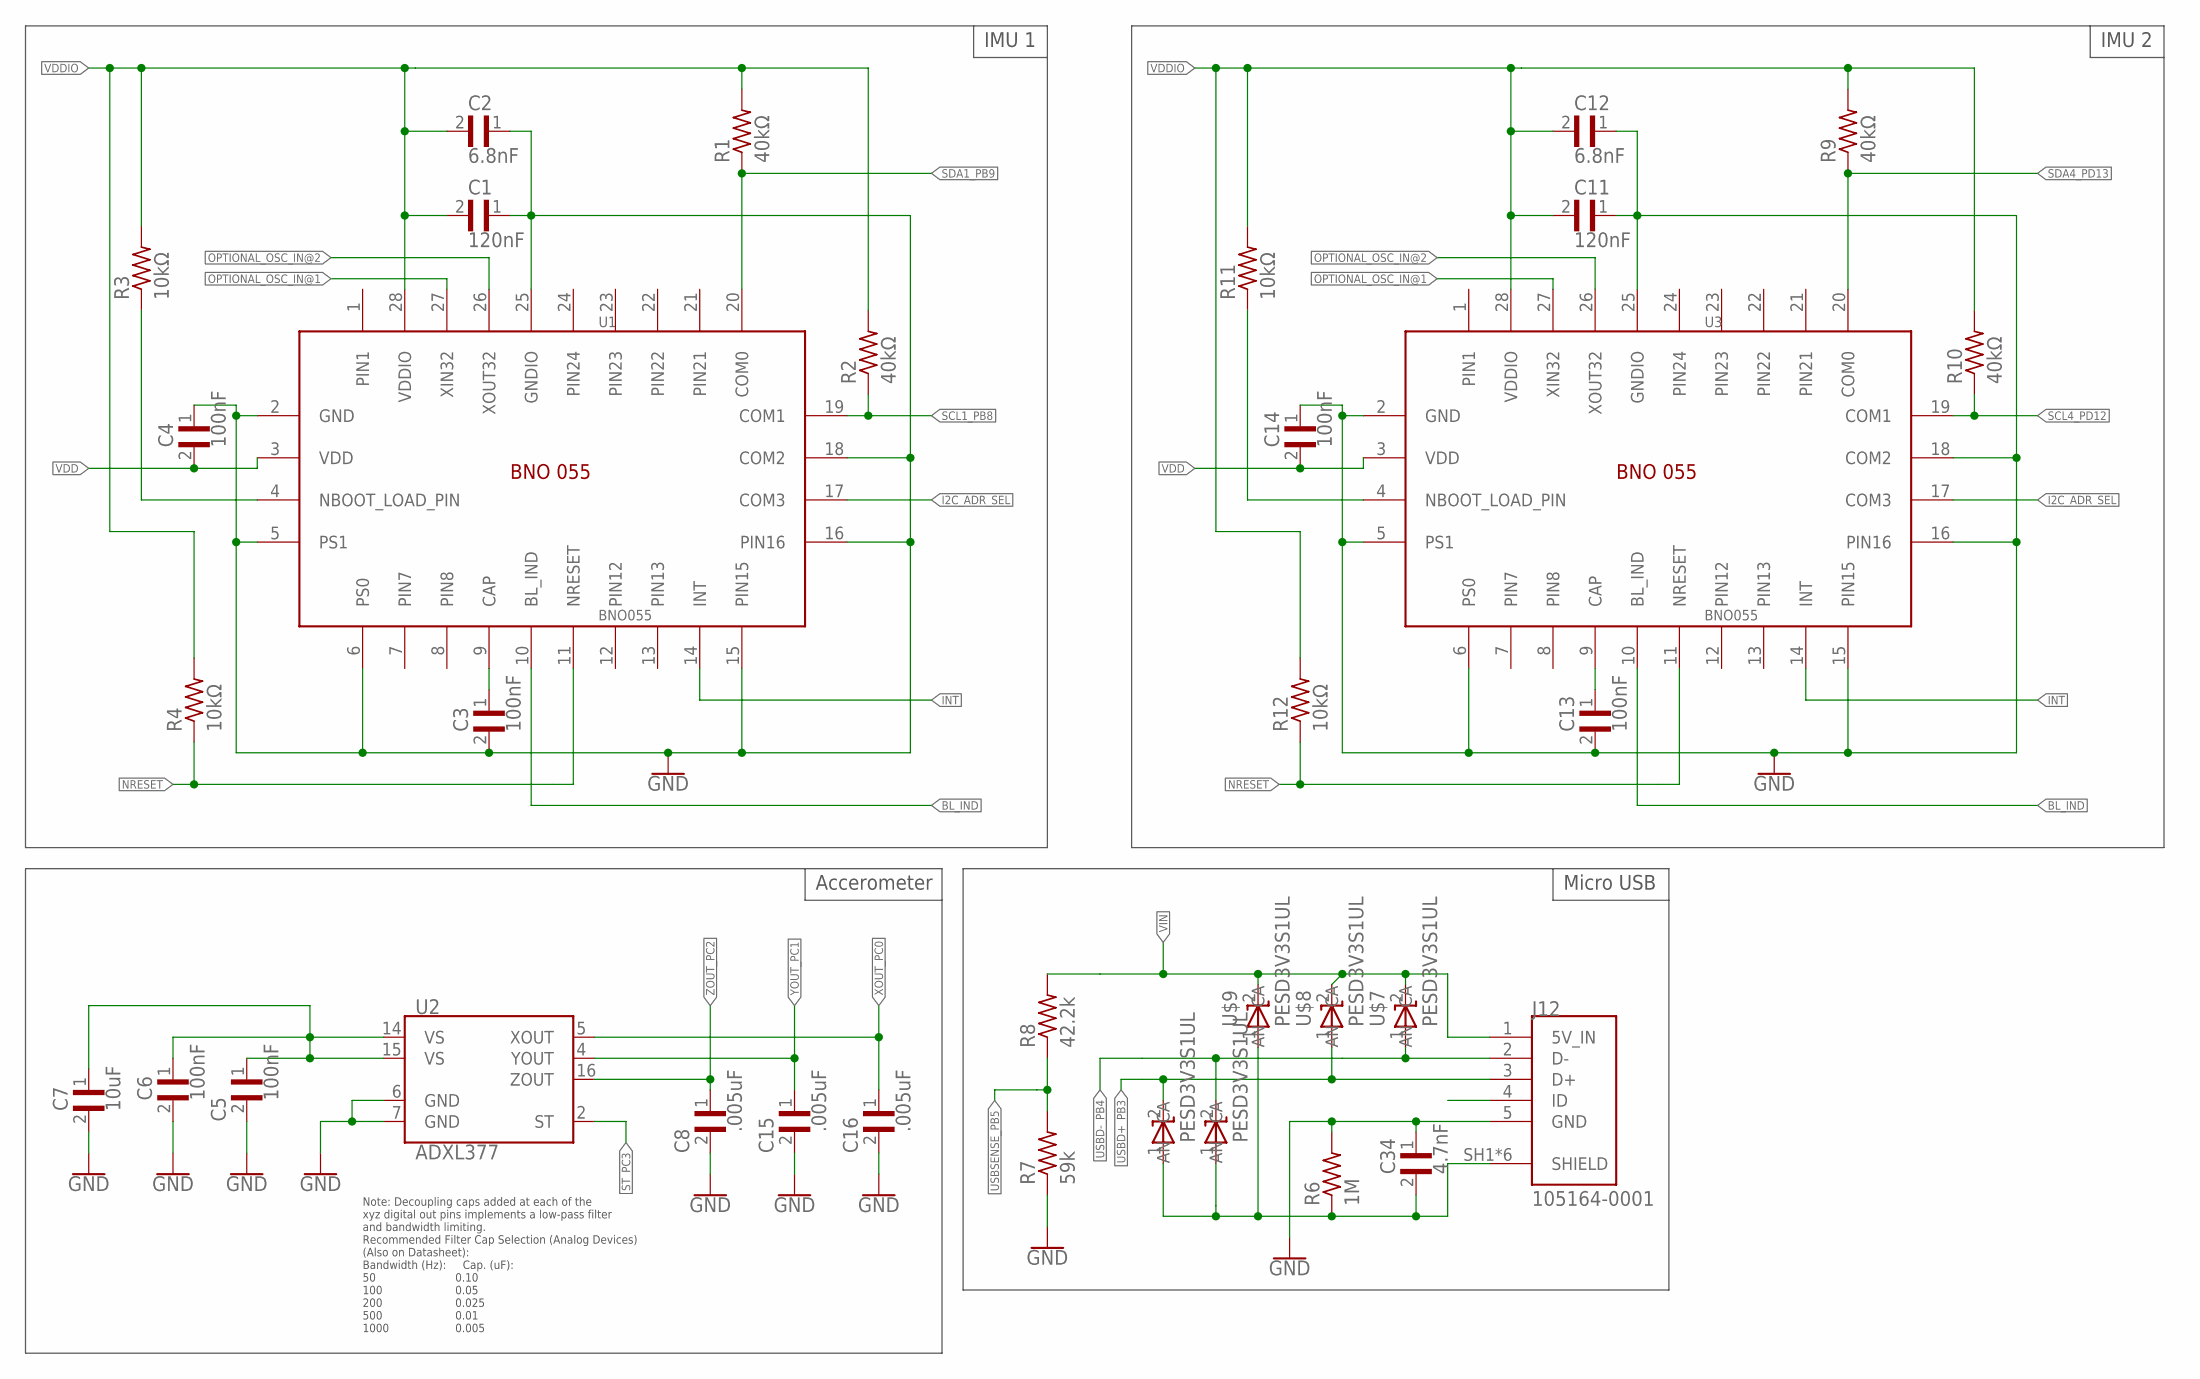
[picture p14: schematic 1906152157-Dev Board.sch, sheet 2]

Parts:
C1, C11: 120nF; CAPC1608X95N
C2, C12: 6.8nF; CAPC1608X95N
C3, C4, C5, C6, C13, C14: 100nF; CAPC1608X95N
C7: 10uF; CAPC1608X95N
C8, C15, C16: .005uF; CAPC1608X95N
C34: 4.7nF; CAPC1608X95N
J12: 105164-0001; MOLEX_105164-0001
R1, R2, R9, R10: 40kΩ; RESC1608X50N
R3, R4, R11, R12: 10kΩ; RESC1608X50N
R6: 1M; RESC1608X50N
R7: 59k; RESC1608X50N
R8: 42.2k; RESC1608X50N
U1, U3: BNO055; LGA28R50P4X10_380X520X100
U2: ADXL377; LFCSP-16-3X3
U$7, U$8, U$9, U$10, U$11: PESD3V3S1UL; SOD882

Connections:
BL_IND: U1.10 (BL_IND), U3.10 (BL_IND)
GND: C1.1, C2.1, C3.2, C4.1, C5.2, C6.2, C7.2, C8.2, C11.1, C12.1, C13.2, C14.1, C15.2, C16.2, C34.1, J12.5 (GND), R6.2, R7.1, U1.2 (GND), U1.5 (PS1), U1.6 (PS0), U1.15 (PIN15), U1.16 (PIN16), U1.18 (COM2), U1.25 (GNDIO), U2.6 (GND), U2.7 (GND), U3.2 (GND), U3.5 (PS1), U3.6 (PS0), U3.15 (PIN15), U3.16 (PIN16), U3.18 (COM2), U3.25 (GNDIO); also elsewhere on the board
I2C_ADR_SEL: U1.17 (COM3), U3.17 (COM3)
INT: U1.14 (INT), U3.14 (INT)
unnamed: C3.1, U1.9 (CAP)
unnamed: R3.1, U1.4 (NBOOT_LOAD_PIN)
unnamed: C13.1, U3.9 (CAP)
unnamed: R11.1, U3.4 (NBOOT_LOAD_PIN)
unnamed: C5.1, C6.1, C7.1, U2.14 (VS), U2.15 (VS)
unnamed: C34.2, J12.SH1 (SHIELD), J12.SH2 (SHIELD), J12.SH3 (SHIELD), J12.SH4 (SHIELD), J12.SH5 (SHIELD), J12.SH6 (SHIELD), R6.1, U$9.1 (CA), U$10.1 (CA), U$11.1 (CA)
NRESET: R4.1, R12.1, U1.11 (NRESET), U3.11 (NRESET)
OPTIONAL_OSC_IN@1: U1.27 (XIN32), U3.27 (XIN32)
OPTIONAL_OSC_IN@2: U1.26 (XOUT32), U3.26 (XOUT32)
PIN7: U1.7 (PIN7), U3.7 (PIN7)
PIN8: U1.8 (PIN8), U3.8 (PIN8)
PIN21: U1.21 (PIN21), U3.21 (PIN21)
PIN22: U1.22 (PIN22), U3.22 (PIN22)
PIN23: U1.23 (PIN23), U3.23 (PIN23)
PIN24: U1.24 (PIN24), U3.24 (PIN24)
SCL1_PB8: R2.1, U1.19 (COM1); also elsewhere on the board
SCL4_PD12: R10.1, U3.19 (COM1); also elsewhere on the board
SDA1_PB9: R1.1, U1.20 (COM0); also elsewhere on the board
SDA4_PD13: R9.1, U3.20 (COM0); also elsewhere on the board
ST_PC3: U2.2 (ST); also elsewhere on the board
USBD+_PB3: J12.3 (D+), U$8.1 (CA), U$11.2 (AN); also elsewhere on the board
USBD-_PB4: J12.2 (D-), U$7.1 (CA), U$10.2 (AN); also elsewhere on the board
USBSENSE_PB5: R7.2, R8.1; also elsewhere on the board
VDD: C4.2, C14.2, U1.3 (VDD), U3.3 (VDD)
VDDIO: C1.2, C2.2, C11.2, C12.2, R1.2, R2.2, R3.2, R4.2, R9.2, R10.2, R11.2, R12.2, U1.28 (VDDIO), U3.28 (VDDIO)
VIN: J12.1 (5V_IN), R8.2, U$7.2 (AN), U$8.2 (AN), U$9.2 (AN); also elsewhere on the board
XOUT_PC0: C16.1, U2.5 (XOUT); also elsewhere on the board
YOUT_PC1: C15.1, U2.4 (YOUT); also elsewhere on the board
ZOUT_PC2: C8.1, U2.16 (ZOUT); also elsewhere on the board

Notes on the sheet:
IMU 1
IMU 2
Note: Decoupling caps added at each of the xyz digital out pins implements a low-pass filter and bandwidth limiting. Recommended Filter Cap Selection (Analog Devices) (Also on Datasheet): Bandwidth (Hz): Cap. (uF): 50 0.10 100 0.05 200 0.025 500 0.01 1000 0.005
Accerometer
Micro USB

Board: 2 copper layers, 73 parts (1 on the bottom side), 78 nets, no tracks yet.
