AerospaceNU/karman-pcb/(commit log)

2019-05-06 David Antaki initial commit
    [Dev Board.sch, Yale spring 2019 FRIDAY.sch]
2019-05-08 5/7/19-Updated FRIDAY Board
    [Yale spring 2019 FRIDAY.sch]
2019-05-14 5/13/19 Dev board update
    [Dev Board.sch]
2019-05-14 5/13/19 10:08PM Dev board update
    [Dev Board.sch]
2019-05-15 5/15/19 Add GPS-Radio Module
    [GPS-Radio Module.sch]
2019-05-25 5/24/19 20:26 PCB Update
    [Dev Board.sch]
2019-05-25 5/25/19 11:45 PCB Issued for Review
    [Dev Board.sch]
2019-05-25 5/25/19 12:47 PCB ISSUED FOR REVIEW
    [Dev Board.sch]
2019-06-16 BOM added
    [1906152158-Dev Board BOM.csv, 1906152158-Dev Board BOM.xlsx, 1906152158-Dev Board.brd, 1906152158-Dev Board.sch, Dev Board.brd, Dev Board.sch]
2019-08-03 DevBoard update 8/2/2019 11:59PM
    [1906152157-Dev Board.brd, 1906152157-Dev Board.sch, 1906152158-Dev Board BOM.xlsx, 1906152158-Dev Board.brd, 1906152158-Dev Board.sch, 1906251730-Dev Board.brd, 1906251730-Dev Board.sch, 1906252155-Dev Board.brd]
2020-05-07 Just some Eagle files that I never committed
    [1908011900-Dev Board.brd, 1908011900-Dev Board.sch, [PRINTED] 1908011900-Dev Board.brd, [PRINTED] 1908011900-Dev Board.sch]
